tobiwan88/esp32-weatherstation/hardware/gen/README.md

Generators go here (`weatherstation_v1.py` schematic, `layout_v1.py` placement). Not written yet.
Start from `../reference/desk_notifier/gen/` (`schkit.py` works around kicad-sch-api pin rotation and label bugs).
