tobiwan88/esp32-weatherstation/hardware/weatherstation-v1/REQUIREMENTS.md

# esp32-weatherstation v1: PCB requirements (v0.4, schematic v1, pre-layout)

Rewritten 2026-11-01 for the schematic in `hardware/gen/weatherstation_v1.py` (BQ25798, LFP 26700, TPS63802). v0.3 described
the CN3791/TP4056/AP2112K/18650 design, which is gone. Details and part numbers: `BOARD.md`, `bom.csv`, `PARTS-REVIEW.md`.
Status: needs user acceptance (Gate 1, `GATES.md`).

## 1. Scope
Custom 4-layer PCB (In1 and In2 solid GND), at most 50 x 50 mm: ESP32-S3-WROOM-1-N8, one BQ25798 charger for USB-C and a
6 V solar panel, one 1S LiFePO4 cell (CBAK 26700LT) with HY2112-CB protection, TPS63802 3.3 V buck-boost, switched sensor
rail 3V3_SW, switched 5 V rail 5V_SW, a Plantower PMS7003 PM sensor (sensor option A, `sensors.md`), SHT45 on a small
board in a radiation shield, an optional SCD41 CO2 footprint (not fitted), a spare Qwiic
port, and an optional ZE25-O3 ozone module on its own 5 V boost. NO2 is out of scope for v1.

## 2. Functional requirements
- F1 Measure PM1/2.5/10 (PMS7003) and outdoor T/RH (SHT45 in a radiation shield). Optional: CO2 (SCD41, fit U8) and O3
  (ZE25-O3, J8). No VOC/NOx index: Sensirion's index needs about 1 Hz sampling and does not work with deep sleep.
- F2 Wake every 10-15 min (longer in winter if the energy budget needs it), measure, send over WiFi (MQTT / Home Assistant),
  deep sleep.
- F3 Charge the cell from USB-C (VBUS, VAC1) or the solar panel (VAC2) through one charger, U3 BQ25798. Each input has its
  own back-to-back N-FET pair (ACFET/RBFET, AO3400A); the chip selects the input. Solar uses the chip's VOC-based MPPT.
- F4 Fail-safe charge enable: CE is pulled high (R20 to +3V3), so the charger does not charge until firmware has written
  the LFP settings (section 6). A blank or reset MCU means no charging. After that, charging stays enabled at all times,
  including deep sleep (CE held low by GPIO hold; user decision 2026-11-01).
- F5 Temperature: NTC TH1 next to the battery connector on the TS pin. Default state: the chip's JEITA limits apply. During an
  awake charge session firmware may take over (cold charging, `charge-policy.md`).
- F6 Report battery voltage, input voltages and currents, charge state and TS through the charger ADC over I2C
  (charger bus); INT to the MCU.
- F7 Program and debug over native USB-C (USB-JTAG and serial on IO19/IO20); RESET (JP1) and BOOT (JP2, IO0) as tweezer pads (engineer 2026-11-03); two status LEDs on IO41/IO42;
  UART0 header J7 as a fallback.
- F8 Sensor rail 3V3_SW switched by Q40 (P-FET), driven by SENSOR_EN (IO11) through Q41; off by default (R40 pull-up).
- F9 5 V rail 5V_SW (PMS7003 and gas module) from U7 TPS61023 on SYS, EN = BOOST_EN (IO12), R45 pull-down: off by default, output
  disconnected when off.

## 3. Electrical requirements
- Cell: 1S LFP, 3.20 V nominal, 3.65 V charge, 3.75 V limit, 2.0 V cut-off, 3900 mAh minimum (CBAK 26700LT spec A/03).
- Protection: HY2112-CB with M60/M61 (AO3400A) in the cell minus: overcharge 3.75 V, overdischarge 2.10 V, charge and
  discharge overcurrent by the FET drop. F1 PTC 3 A hold between the connector and the battery node. Cell reverse polarity is
  not protected (keyed JST PH).
- Charge current: ICHG at most 1.5 A (HY2112 charge overcurrent margin and L1 rating, `power_budget.py`). Input current clamp
  ILIM_HIZ = 1.59 A (R15/R16); firmware sets IINDPM per source.
- Order of cut-offs: cell 2.0 V <= HY2112 2.10 V < firmware cut-off 2.4 V (sensors off, long sleep).
- 3.3 V: U2 TPS63802 from SYS, 1.3-5.5 V in (1.8 V to start), 2 A, FB 220k/39k = 3.32 V. Covers the whole LFP range.
- PMS7003: 4.5-5.5 V, <= 100 mA active, <= 200 uA standby, stable data 30 s after wake-up (manual V2.5), on 5V_SW; UART2
  IO4 (TX, via R48 1k) / IO5 (RX), SET on IO6 via R49 1k. J2 2x5 1.27 mm, hand-soldered.
- SCD41 (DNP): 2.4-5.5 V, peak 205 mA at 3.3 V, supply ripple <= 30 mV, single shot 0.45 mA average at 1 per 5 min
  (SCD4x datasheet v1.7); on 3V3_SW and the sensor I2C bus; C47 10 uF.
- Gas module: 5V_SW 5.06 V (FB 510k/68k) to ZE25-O3 Vin (3.7-5.5 V). J8 7-pin, numbered 1:1 to the module (Winsen table 2):
  2 DAC (0.4-2.0 V = 0-10 ppm) to IO7, 3 GND, 4 Vin, 5 RXD (0-3.0 V) from IO17 through R46 1k / R47 10k, 6 TXD (0-3.0 V) to
  IO18, 1 and 7 reserved. Supply current and cable pitch open.
- PV input: 6 V class panel, Voc must stay at or below 10 V cold (SMBJ10A standoff). Reference panel Voltaic P110: Vmp 5.71 V,
  Voc 6.94 V, 9.5 W (`board.yaml` panel).
- I2C: charger bus CHG_SDA/CHG_SCL on IO1/IO2 (RTC I2C pins usable by the ULP RISC-V core) with 10k pull-ups to +3V3; sensor bus SEN_SDA/SEN_SCL on IO13/IO14 with 10k
  pull-ups to 3V3_SW (no back-power into unpowered sensors).
- MCU pins: IO1/IO2 charger I2C, IO4/IO5 PM UART, IO6 PM_SET, IO7 GAS_DAC, IO9 CHG_CE, IO10 CHG_INT, IO11 SENSOR_EN, IO12 BOOST_EN, IO17 GAS_TXD, IO18 GAS_RXD, IO19/IO20 USB, IO43/IO44 UART0.
  Strapping pins (IO0, IO3, IO45, IO46) carry no load except BOOT on IO0.
- USB: CC1/CC2 5.1k to GND (sink), D+/D- through 22 ohm to the ESP32 and shared with the BQ25798 D+/D- (BC1.2 detection once,
  then AUTO_INDET_EN = 0).
- Deep-sleep board current target: under 100 uA with 3V3_SW and 5V_SW off (TPS63802 Iq 11 uA, FB divider 13 uA; measure
  the charger and HY2112 share on the first board).
- Energy: average about 10.8 mA at a 600 s cycle, 0.96 Wh/day; 12 days autonomy from 80 % of 3900 mAh; worst-month solar
  4.2 Wh/day with a 10 W panel (`power_budget.py`).

## 4. Environmental / mechanical
- Outdoor station in Germany: -20 to +40 C ambient. Cell: discharge -40 to 60 C, charge -10 to 50 C (spec). PMS7003 working range
  -10 to +60 C, 0-99 %RH (manual V2.5); PM readings above about 80 %RH are flagged (all low-cost PM sensors overread in fog).
- Vented enclosure with rain baffle for the PM inlet; board conformal-coated except connectors. PMS7003 and SCD41 need air exchange with outside air.
- Board at most 50 x 50 mm, M3 mounting holes, ESP32 antenna at the board edge with a keepout on all layers.

## 4a. Thermal
- T1 Heat sources: BQ25798 + L1 (up to 1.5 A charge), TPS63802 + L4, TPS61023 + L5 when on, ESP32 during WiFi TX, PMS7003 (fan) in its own housing.
  Group the converters in one heat corner, away from TH1, the antenna and the sensor connectors.
- T2 TH1 next to J6 and the cell holder, outside the heat corner; sense trace not under a converter. TH1 reads the board next
  to the cell: measure the TH1-to-cell offset on the samples (`charge-policy.md`).
- T3 J2/J3/J8 on the side opposite the heat corner. The SHT45 is off-board in a radiation shield.
- T4 BQ25798 exposed pad, TPS63802 GND bar and ESP32 EP on via arrays into both GND planes.
- T5 Keep the board temperature rise under 25 C at 1.5 A charge in the closed enclosure; verify on the first board.
- T6 Optional milled slots between the heat corner and the sensor side if measurement shows coupling; slots must not cut
  return paths.

## 4b. EMC
- E1 Targets (personal use): EN 55032 Class B emissions, IEC 61000-4-2 +/-4 kV contact / +/-8 kV air on external ports.
  Selling in the EU would need RED testing of the whole product.
- E2 In1 and In2 solid GND, no splits under signals; stitching vias along the edge every 5 mm or closer.
- E3 Switching loops (BQ25798 SW1/SW2 + L1 + PMID/SYS caps, TPS63802, TPS61023) as small as the datasheet layouts; input caps
  next to the pins; no signals under the inductors on the outer layers.
- E4 Antenna keepout on all layers per the WROOM-1 guideline, at least 15 mm from the cell, the PV wiring and metal parts.
- E5 ESD: U4 USBLC6-2SC6 at J1 (D+/D-, VBUS); U5 USBLC6-2SC6 on SEN_SDA/SEN_SCL (outdoor SHT45 cable); D1 SMBJ10A across
  PV+/PV- before the common-mode choke L3 (CMF4532F-900, 90 ohm at 100 MHz, 3 A), C2 after it.
- E6 I2C at 100 kHz, short stubs. Ferrite plus 100 nF at a cable entry only if a scan shows a problem.
- E7 Analog (TS divider, NTC) over solid ground, away from switch nodes.
- E8 Verification: near-field scan, ESD gun on the connectors, scope on the switch nodes and +3V3 ripple, WiFi range with the
  box closed.

## 4c. USB programming and debugging
- U1 Native USB-C J1 on IO19/IO20: flashing, serial console, JTAG. RESET and BOOT buttons.
- U2 USB also powers the board and charges the cell through the BQ25798 (after firmware releases CE).
- U3 UART0 header J7 (3V3, TXD0, RXD0, GND); test points TP1 +3V3 and TP2 SYS.

## 5. Manufacturing (JLCPCB)
- 4 layers, 1.6 mm, ENIG preferred; standard stackup (JLC04161H-7628 or similar), no impedance control needed.
- Stackup: F.Cu parts, signals, power pours / In1 GND / In2 GND / B.Cu signals and power pours. Planes unbroken and stitched.
- SMT top side only (Economic PCBA if JLCPCB accepts the ESP32 module there). Hand-soldered: J5-J8 (JST PH, header).
- Deliverables at layout: Gerbers, drill, BOM, CPL with checked rotations; check exports for metadata before committing.

## 5a. Cost (2026-11-01, `bom.csv` and `hw-check.sh --stock`)
- Parts per board about USD 13.76; Extended fee 15 x USD 3.07 = USD 46.05 per order. 5 boards: about USD 115 in parts plus
  fees, before PCB, setup, stencil, shipping and VAT (Economic PCBA setup about USD 8.18 + stencil USD 1.53).
- Risk: Standard PCBA for the ESP32 module adds about USD 40-50 (check the quote).
- Per station, outside the board (estimates): PMS7003 about EUR 12-18 with cable, SHT45 board a few EUR (own PCB), radiation shield about EUR 8,
  10 W 6 V panel EUR 20-60 (Voltaic P110 USD 65), CBAK 26700LT cell and holder (price open), enclosure about EUR 20, cables EUR 8.

## 6. Firmware requirements
- PMS7003: BOOST_EN (IO12) high -> 30 s warm-up -> read a few frames (passive mode) -> BOOST_EN low (or SET low if the O3
  module keeps 5V_SW on). Drive IO4/IO6 low while 5V_SW is off.
- SHT45 (and SCD41 if fitted): SENSOR_EN (IO11) high -> read (SCD41 single shot, 5 s) -> low. Task watchdog and RTC-timer wake.
- BQ25798 (PARTS-REVIEW B3/B5, 2026-11-01): at every boot write VREG 3.65 V and ICHG before releasing CE (CE is pulled high =
  charge off). Disable the charger I2C watchdog (WATCHDOG = 00), or re-write VREG before each sleep: on watchdog expiry the
  registers return to POR defaults (VREG 4.2 V, ICHG 1 A); the HY2112 3.75 V cut is only the backstop. Keep ICHG at 1.5 A or
  below (L1 Isat 3 A, B4). After the first BC1.2 detection set AUTO_INDET_EN = 0 so D+/D- stay free for the ESP32 USB.
- MPPT: EN_MPPT = 1, VOC_PCT 0.8125 for the reference panel (Vmp/Voc 0.823).
- Charging always on (user, 2026-11-01): CE low and held through deep sleep; TS_IGNORE = 0 in sleep (chip JEITA). Cold
  charging below the chip's limit only in an awake session or by the ULP core (`charge-policy.md`).
- I2C: charger bus IO1/IO2, sensor bus IO13/IO14. Set IO13/IO14 to input or low before switching 3V3_SW off.
- Gas: BOOST_EN (IO12) high = TPS61023 on; drive GAS_TXD (IO17) low or input while the boost is off.
- O3 option (user 2026-11-01): firmware feature to keep 5V_SW on longer for the ZE25-O3 (warm-up <= 3 min, response
  <= 90 s), e.g. one 4 min window per hour (configurable, off by default), with the PMS7003 in sleep (SET low) meanwhile.
  Budget in `board.yaml` cycle.o3_* (current is an assumption until measured).
- Battery: below 2.4 V turn sensors off and sleep long; report the charger ADC values each cycle.

## 7. Open items before ordering
1. ZE25-O3 cable/connector pitch (J8). Supply current: 10 mA at 5 V (user, 2026-11-04).
2. CMF4532F-900 land pattern and pinout from a HongyeX drawing (the footprint uses the EMTEK drawing).
3. JLCPCB Standard vs Economic PCBA for the ESP32 module (quote).
4. SHT45 board: schematic in `hardware/sht45-board/` (layout open).
5. Layout not started; plan one prototype batch and bench-test charging, sleep current and the TH1-to-cell offset.
