tobiwan88/esp32-weatherstation/hardware/weatherstation-v1/weatherstation-v1.kicad_pcb

## KiCad design hardware/weatherstation-v1/weatherstation-v1.kicad_pcb (2026-11-05)

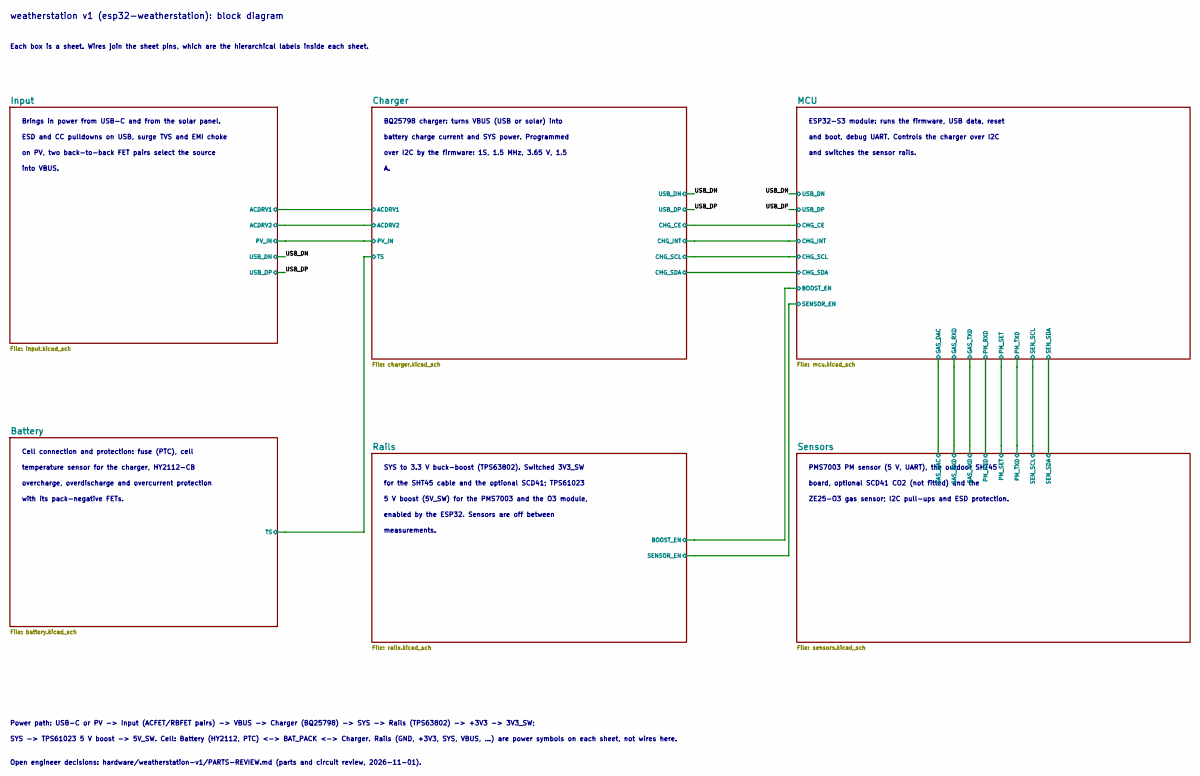
[picture p1: schematic weatherstation-v1.kicad_sch, weatherstation v1]

Notes on the sheet:
weatherstation v1 (esp32-weatherstation): block diagram
Each box is a sheet. Wires join the sheet pins, which are the hierarchical labels inside each sheet.
Power path: USB-C or PV -> Input (ACFET/RBFET pairs) -> VBUS -> Charger (BQ25798) -> SYS -> Rails (TPS63802) -> +3V3 -> 3V3_SW;
SYS -> TPS61023 5 V boost -> 5V_SW. Cell: Battery (HY2112, PTC) <-> BAT_PACK <-> Charger. Rails (GND, +3V3, SYS, VBUS, ...) are power symbols on each sheet, not wires here.
Open engineer decisions: hardware/weatherstation-v1/PARTS-REVIEW.md (parts and circuit review, 2026-11-01).
Brings in power from USB-C and from the solar panel.
ESD and CC pulldowns on USB, surge TVS and EMI choke
on PV, two back-to-back FET pairs select the source
into VBUS.
BQ25798 charger: turns VBUS (USB or solar) into
battery charge current and SYS power. Programmed
over I2C by the firmware: 1S, 1.5 MHz, 3.65 V, 1.5
Cell connection and protection: fuse (PTC), cell
temperature sensor for the charger, HY2112-CB
overcharge, overdischarge and overcurrent protection
with its pack-negative FETs.
ESP32-S3 module: runs the firmware, USB data, reset
and boot, debug UART. Controls the charger over I2C
and switches the sensor rails.
SYS to 3.3 V buck-boost (TPS63802). Switched 3V3_SW
for the SHT45 cable and the optional SCD41; TPS61023
5 V boost (5V_SW) for the PMS7003 and the O3 module,
enabled by the ESP32. Sensors are off between
measurements.
PMS7003 PM sensor (5 V, UART), the outdoor SHT45
board, optional SCD41 CO2 (not fitted) and the
ZE25-O3 gas sensor; I2C pull-ups and ESD protection.

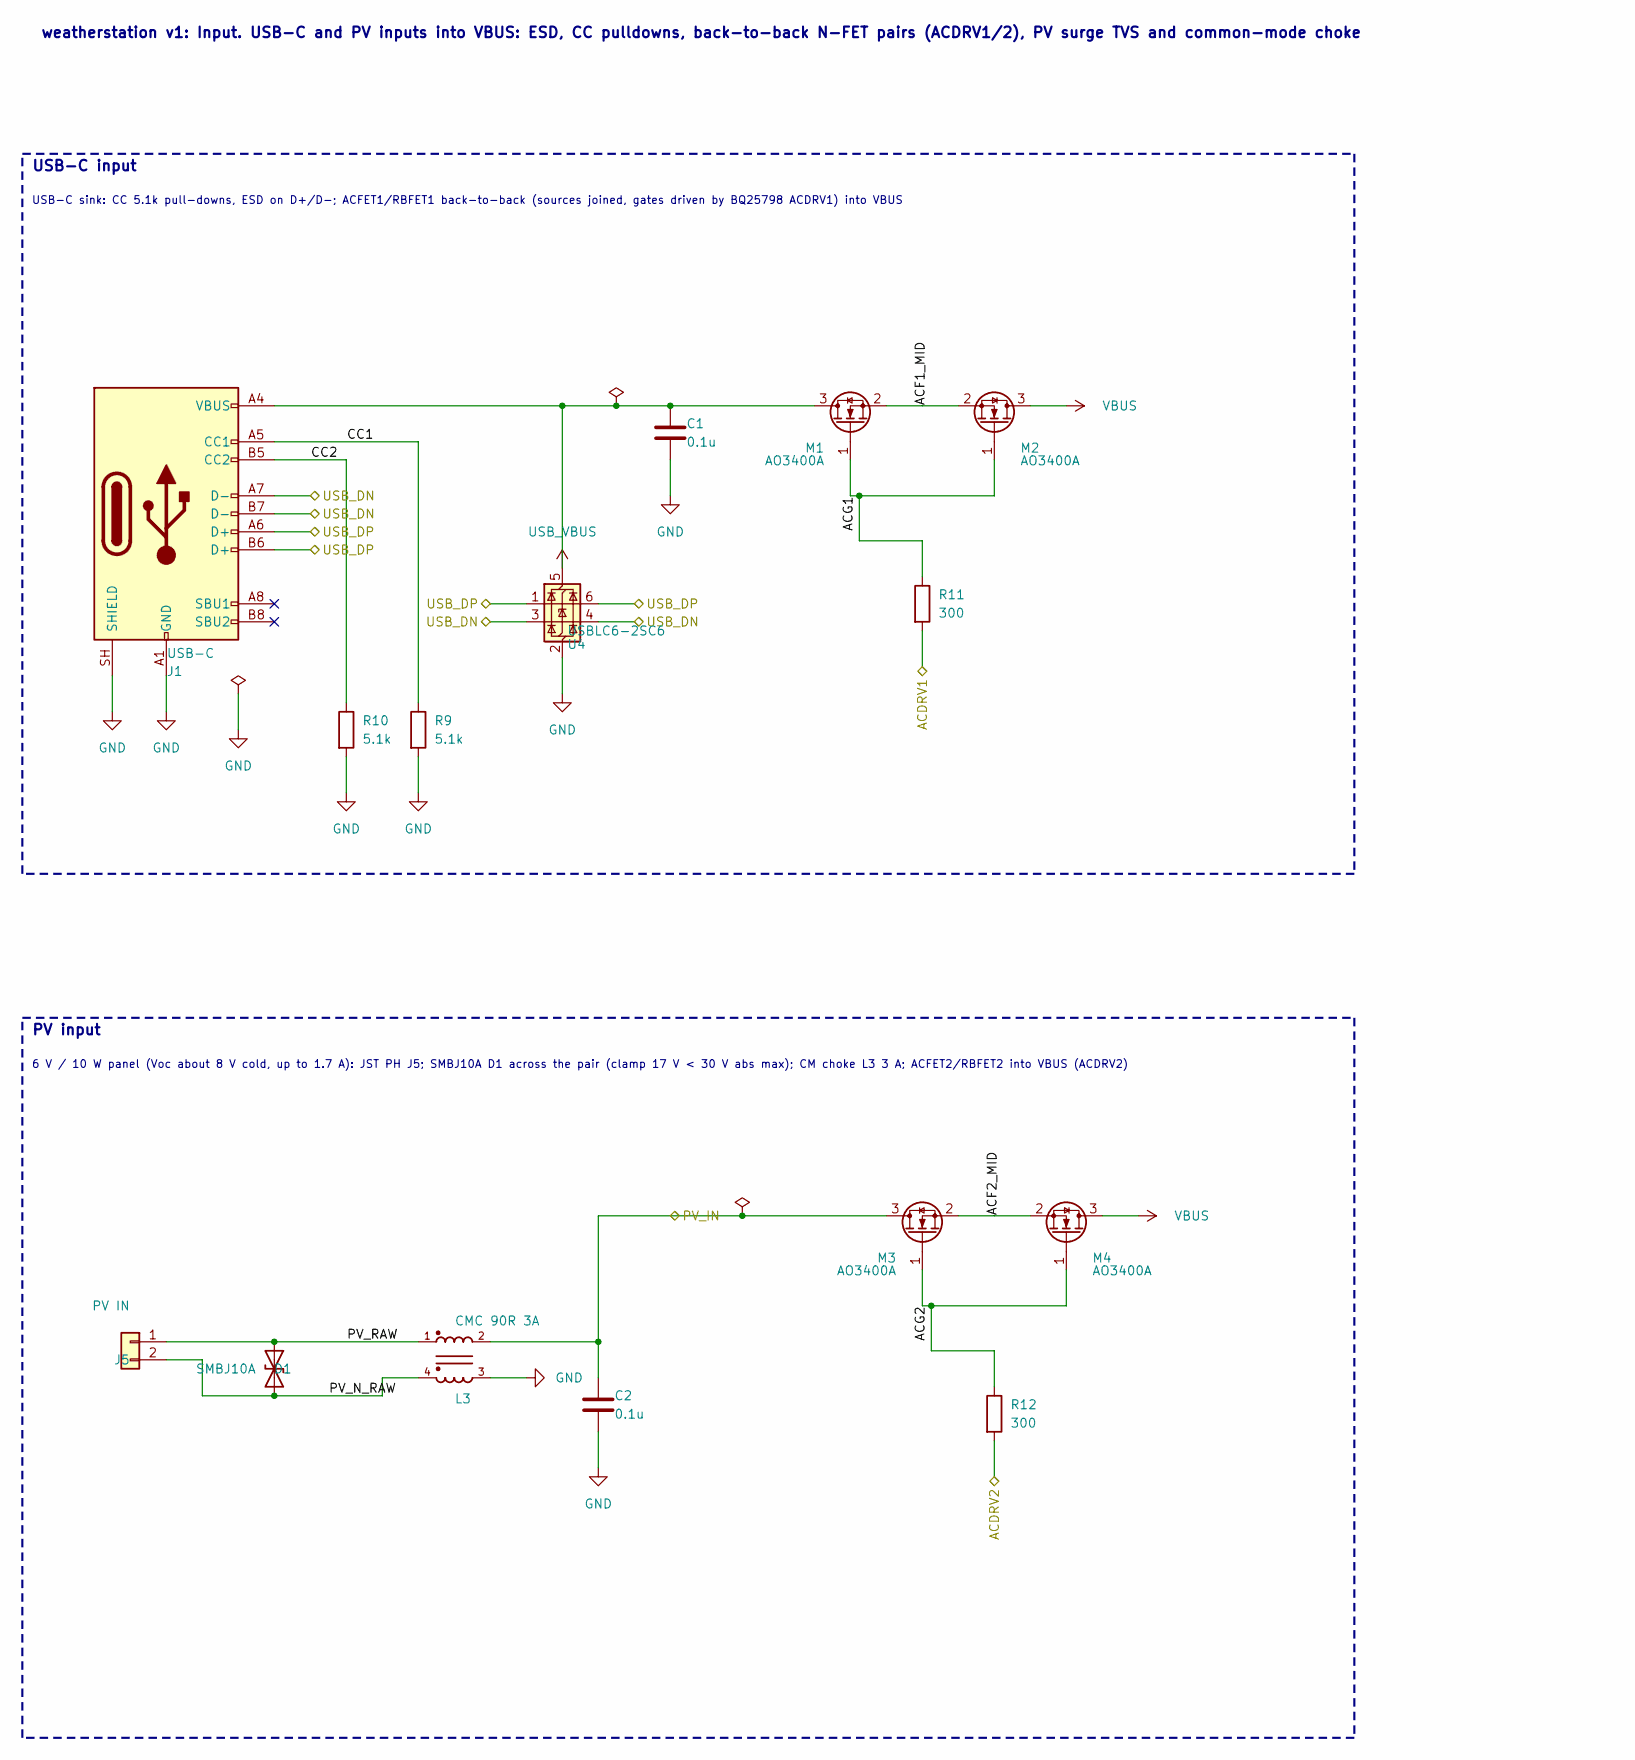
[picture p2: schematic input.kicad_sch, weatherstation v1]

Parts:
C1, C2: 0.1u; C_0402_1005Metric; LCSC C307331
D1: SMBJ10A; D_SMB; LCSC C151250
J1: USB-C; USB_C_Receptacle_HRO_TYPE-C-31-M-12; LCSC C165948
J5: PV IN; JST_PH_B2B-PH-K_1x02_P2.00mm_Vertical
L3: CMC 90R 3A; CMF4532F_4P; LCSC C963746
M1, M2, M3, M4: AO3400A; SOT-23; LCSC C20917
R9, R10: 5.1k; R_0402_1005Metric; LCSC C25905
R11, R12: 300; R_0603_1608Metric; LCSC C23025
U4: USBLC6-2SC6; SOT-23-6; LCSC C7519

Connections:
/Charger/ACDRV1: R11.2; also elsewhere on the board
/Charger/ACDRV2: R12.2; also elsewhere on the board
/Charger/PV_IN: C2.1, L3.2, M3.3 (D); also elsewhere on the board
/Input/ACF1_MID: M1.2 (S), M2.2 (S)
/Input/ACF2_MID: M3.2 (S), M4.2 (S)
/Input/ACG1: M1.1 (G), M2.1 (G), R11.1
/Input/ACG2: M3.1 (G), M4.1 (G), R12.1
/Input/CC1: J1.A5 (CC1), R9.1
/Input/CC2: J1.B5 (CC2), R10.1
/Input/PV_N_RAW: D1.2 (A2), J5.2, L3.4
/Input/PV_RAW: D1.1 (A1), J5.1, L3.1
/USB_DN: J1.A7 (D-), J1.B7 (D-), U4.3 (I/O2), U4.4 (I/O2); also elsewhere on the board
/USB_DP: J1.A6 (D+), J1.B6 (D+), U4.1 (I/O1), U4.6 (I/O1); also elsewhere on the board
GND: C1.2, C2.2, J1.A1 (GND), J1.A12 (GND), J1.B1 (GND), J1.B12 (GND), J1.SH (SHIELD), L3.3, R9.2, R10.2, U4.2 (GND); also elsewhere on the board
USB_VBUS: C1.1, J1.A4 (VBUS), J1.A9 (VBUS), J1.B4 (VBUS), J1.B9 (VBUS), M1.3 (D), U4.5 (VBUS); also elsewhere on the board
VBUS: M2.3 (D), M4.3 (D); also elsewhere on the board

Notes on the sheet:
USB-C input
USB-C sink: CC 5.1k pull-downs, ESD on D+/D-; ACFET1/RBFET1 back-to-back (sources joined, gates driven by BQ25798 ACDRV1) into VBUS
PV input
6 V / 10 W panel (Voc about 8 V cold, up to 1.7 A): JST PH J5; SMBJ10A D1 across the pair (clamp 17 V < 30 V abs max); CM choke L3 3 A; ACFET2/RBFET2 into VBUS (ACDRV2)
weatherstation v1: Input. USB-C and PV inputs into VBUS: ESD, CC pulldowns, back-to-back N-FET pairs (ACDRV1/2), PV surge TVS and common-mode choke

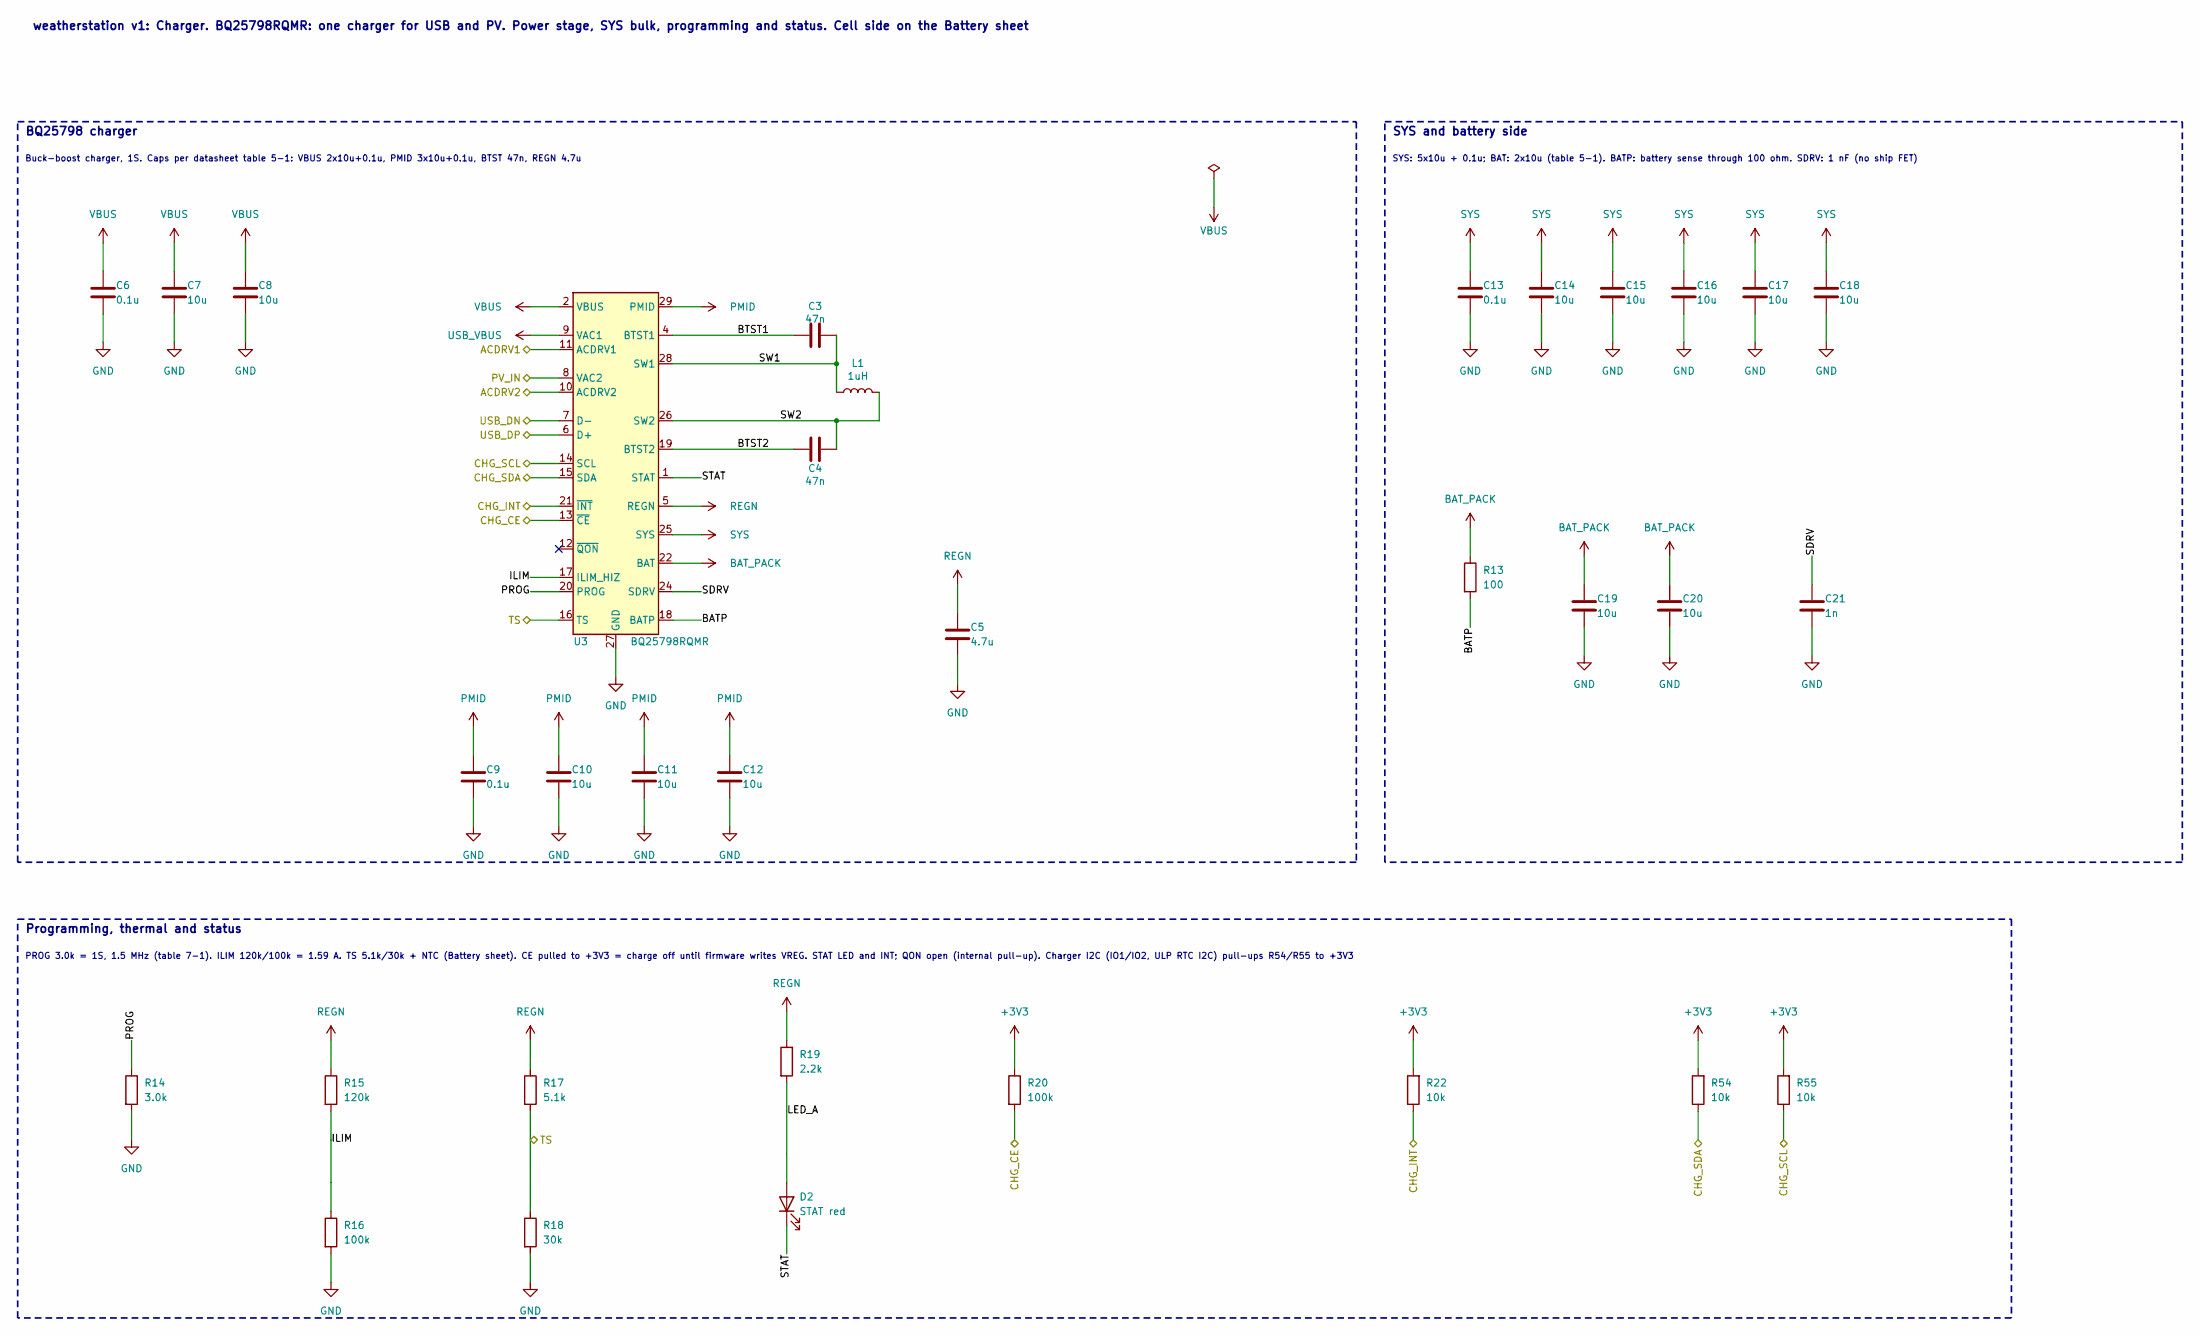
[picture p3: schematic charger.kicad_sch, weatherstation v1]

Parts:
C3, C4: 47n; C_0603_1608Metric; LCSC C1622
C5: 4.7u; C_0603_1608Metric; LCSC C19666
C6, C9, C13: 0.1u; C_0402_1005Metric; LCSC C307331
C7, C8, C10, C11, C12, C14, C15, C16, C17, C18, C19, C20: 10u; C_0805_2012Metric; LCSC C15850
C21: 1n; C_0402_1005Metric; LCSC C1523
D2: STAT red; LED_0603_1608Metric; LCSC C2286
L1: 1uH; L_TDK_VLS252010; LCSC C88211
R13: 100; R_0402_1005Metric; LCSC C25076
R14: 3.0k; R_0603_1608Metric; LCSC C4211
R15: 120k; R_0603_1608Metric; LCSC C25808
R16, R20: 100k; R_0402_1005Metric; LCSC C25741
R17: 5.1k; R_0402_1005Metric; LCSC C25905
R18: 30k; R_0603_1608Metric; LCSC C22984
R19: 2.2k; R_0402_1005Metric; LCSC C25879
R22, R54, R55: 10k; R_0402_1005Metric; LCSC C25744
U3: BQ25798RQMR; Texas_RQM0029A_VQFN-29_4x4mm_P0.4mm; LCSC C2876593

Connections:
+3V3: R20.1, R22.2, R54.2, R55.2; also elsewhere on the board
/Battery/TS: R17.2, R18.1, U3.16 (TS); also elsewhere on the board
/Charger/ACDRV1: U3.11 (ACDRV1); also elsewhere on the board
/Charger/ACDRV2: U3.10 (ACDRV2); also elsewhere on the board
/Charger/BATP: R13.2, U3.18 (BATP)
/Charger/BTST1: C3.1, U3.4 (BTST1)
/Charger/BTST2: C4.1, U3.19 (BTST2)
/Charger/CHG_CE: R20.2, U3.13 (~CE); also elsewhere on the board
/Charger/CHG_INT: R22.1, U3.21 (~INT); also elsewhere on the board
/Charger/CHG_SCL: R55.1, U3.14 (SCL); also elsewhere on the board
/Charger/CHG_SDA: R54.1, U3.15 (SDA); also elsewhere on the board
/Charger/ILIM: R15.2, R16.1, U3.17 (ILIM_HIZ)
/Charger/LED_A: D2.2 (A), R19.2
/Charger/PROG: R14.1, U3.20 (PROG)
/Charger/PV_IN: U3.8 (VAC2); also elsewhere on the board
/Charger/SDRV: C21.1, U3.24 (SDRV)
/Charger/STAT: D2.1 (K), U3.1 (STAT)
/Charger/SW1: C3.2, L1.1, U3.28 (SW1)
/Charger/SW2: C4.2, L1.2, U3.26 (SW2)
/USB_DN: U3.7 (D-); also elsewhere on the board
/USB_DP: U3.6 (D+); also elsewhere on the board
BAT_PACK: C19.1, C20.1, R13.1, U3.22 (BAT), U3.23 (BAT); also elsewhere on the board
GND: C5.2, C6.2, C7.2, C8.2, C9.2, C10.2, C11.2, C12.2, C13.2, C14.2, C15.2, C16.2, C17.2, C18.2, C19.2, C20.2, C21.2, R14.2, R16.2, R18.2, U3.27 (GND); also elsewhere on the board
PMID: C9.1, C10.1, C11.1, C12.1, U3.29 (PMID)
REGN: C5.1, R15.1, R17.1, R19.1, U3.5 (REGN)
SYS: C13.1, C14.1, C15.1, C16.1, C17.1, C18.1, U3.25 (SYS); also elsewhere on the board
USB_VBUS: U3.9 (VAC1); also elsewhere on the board
VBUS: C6.1, C7.1, C8.1, U3.2 (VBUS), U3.3 (VBUS); also elsewhere on the board

Notes on the sheet:
BQ25798 charger
Buck-boost charger, 1S. Caps per datasheet table 5-1: VBUS 2x10u+0.1u, PMID 3x10u+0.1u, BTST 47n, REGN 4.7u
SYS and battery side
SYS: 5x10u + 0.1u; BAT: 2x10u (table 5-1). BATP: battery sense through 100 ohm. SDRV: 1 nF (no ship FET)
Programming, thermal and status
PROG 3.0k = 1S, 1.5 MHz (table 7-1). ILIM 120k/100k = 1.59 A. TS 5.1k/30k + NTC (Battery sheet). CE pulled to +3V3 = charge off until firmware writes VREG. STAT LED and INT; QON open (internal pull-up). Charger I2C (IO1/IO2, ULP RTC I2C) pull-ups R54/R55 to +3V3
weatherstation v1: Charger. BQ25798RQMR: one charger for USB and PV. Power stage, SYS bulk, programming and status. Cell side on the Battery sheet

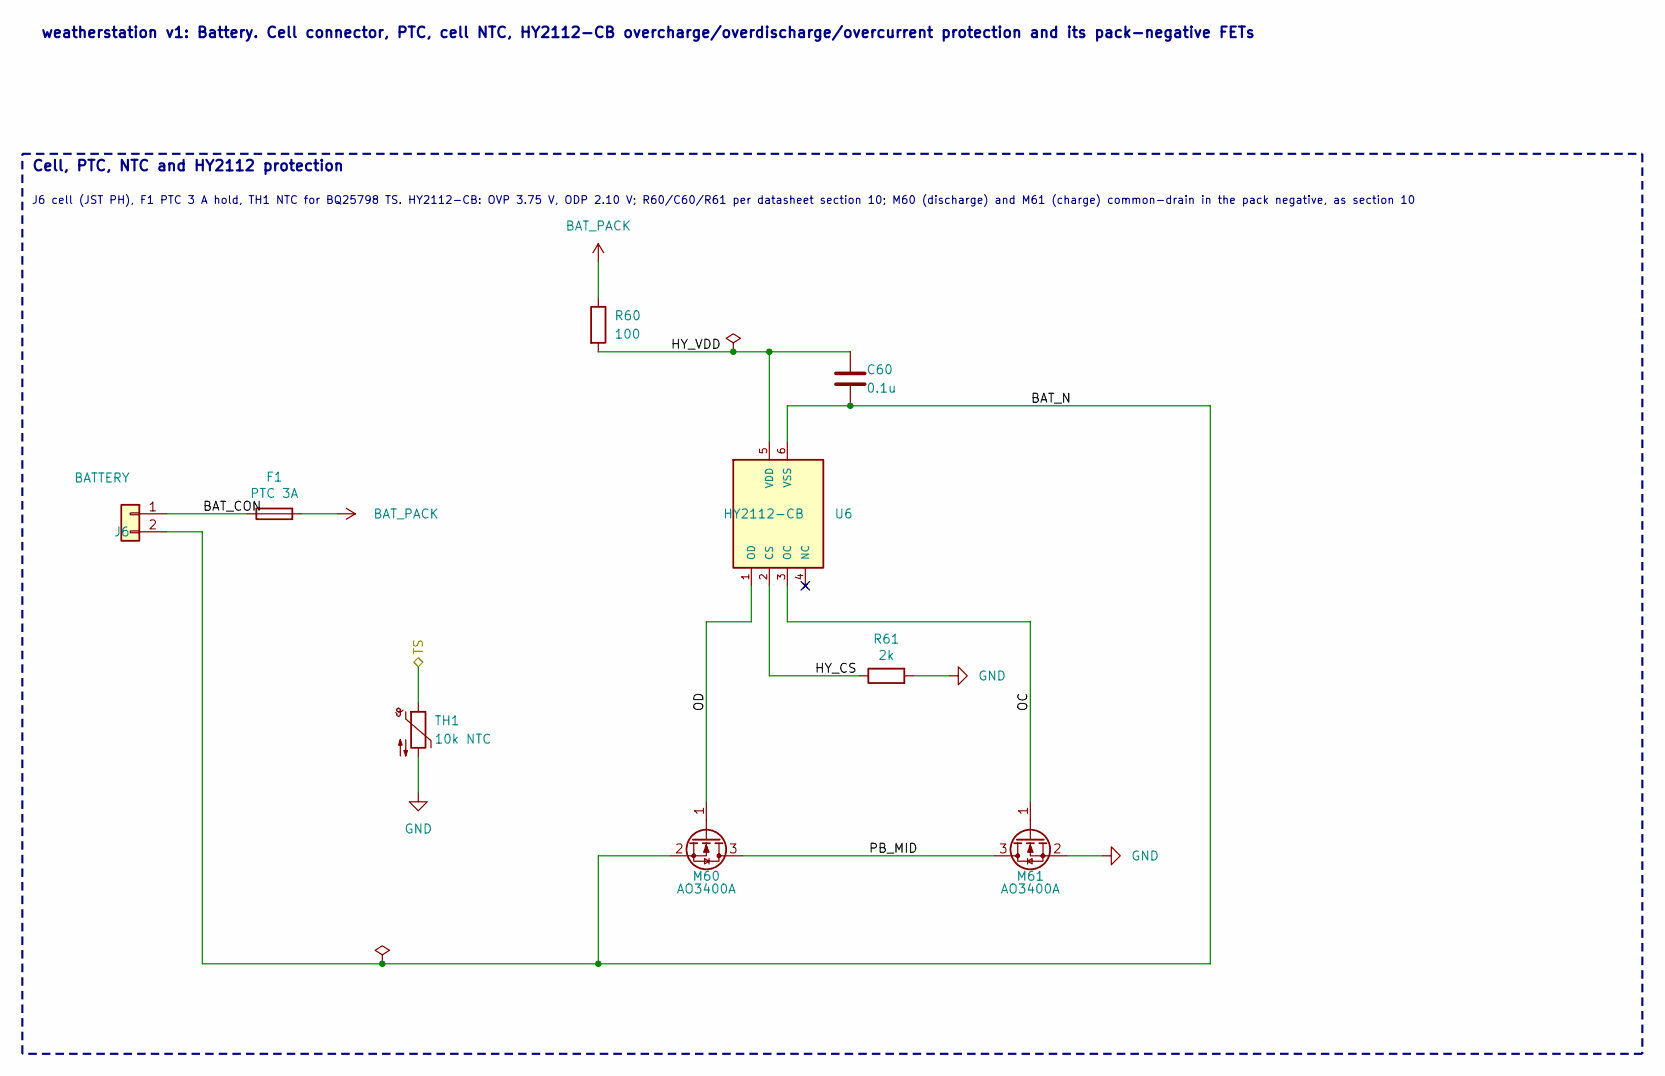
[picture p4: schematic battery.kicad_sch, weatherstation v1]

Parts:
C60: 0.1u; C_0402_1005Metric; LCSC C307331
F1: PTC 3A; Fuse_1812_4532Metric; LCSC C21004
J6: BATTERY; JST_PH_B2B-PH-K_1x02_P2.00mm_Vertical
M60, M61: AO3400A; SOT-23; LCSC C20917
R60: 100; R_0402_1005Metric; LCSC C25076
R61: 2k; R_0402_1005Metric; LCSC C4109
TH1: 10k NTC; R_0603_1608Metric; LCSC C13564
U6: HY2112-CB; SOT-23-6; LCSC C168764

Connections:
/Battery/BAT_CON: F1.1, J6.1
/Battery/BAT_N: C60.2, J6.2, M60.2 (S), U6.6 (VSS)
/Battery/HY_CS: R61.1, U6.2 (CS)
/Battery/HY_VDD: C60.1, R60.2, U6.5 (VDD)
/Battery/OC: M61.1 (G), U6.3 (OC)
/Battery/OD: M60.1 (G), U6.1 (OD)
/Battery/PB_MID: M60.3 (D), M61.3 (D)
/Battery/TS: TH1.1; also elsewhere on the board
BAT_PACK: F1.2, R60.1; also elsewhere on the board
GND: M61.2 (S), R61.2, TH1.2; also elsewhere on the board

Notes on the sheet:
Cell, PTC, NTC and HY2112 protection
J6 cell (JST PH), F1 PTC 3 A hold, TH1 NTC for BQ25798 TS. HY2112-CB: OVP 3.75 V, ODP 2.10 V; R60/C60/R61 per datasheet section 10; M60 (discharge) and M61 (charge) common-drain in the pack negative, as section 10
weatherstation v1: Battery. Cell connector, PTC, cell NTC, HY2112-CB overcharge/overdischarge/overcurrent protection and its pack-negative FETs

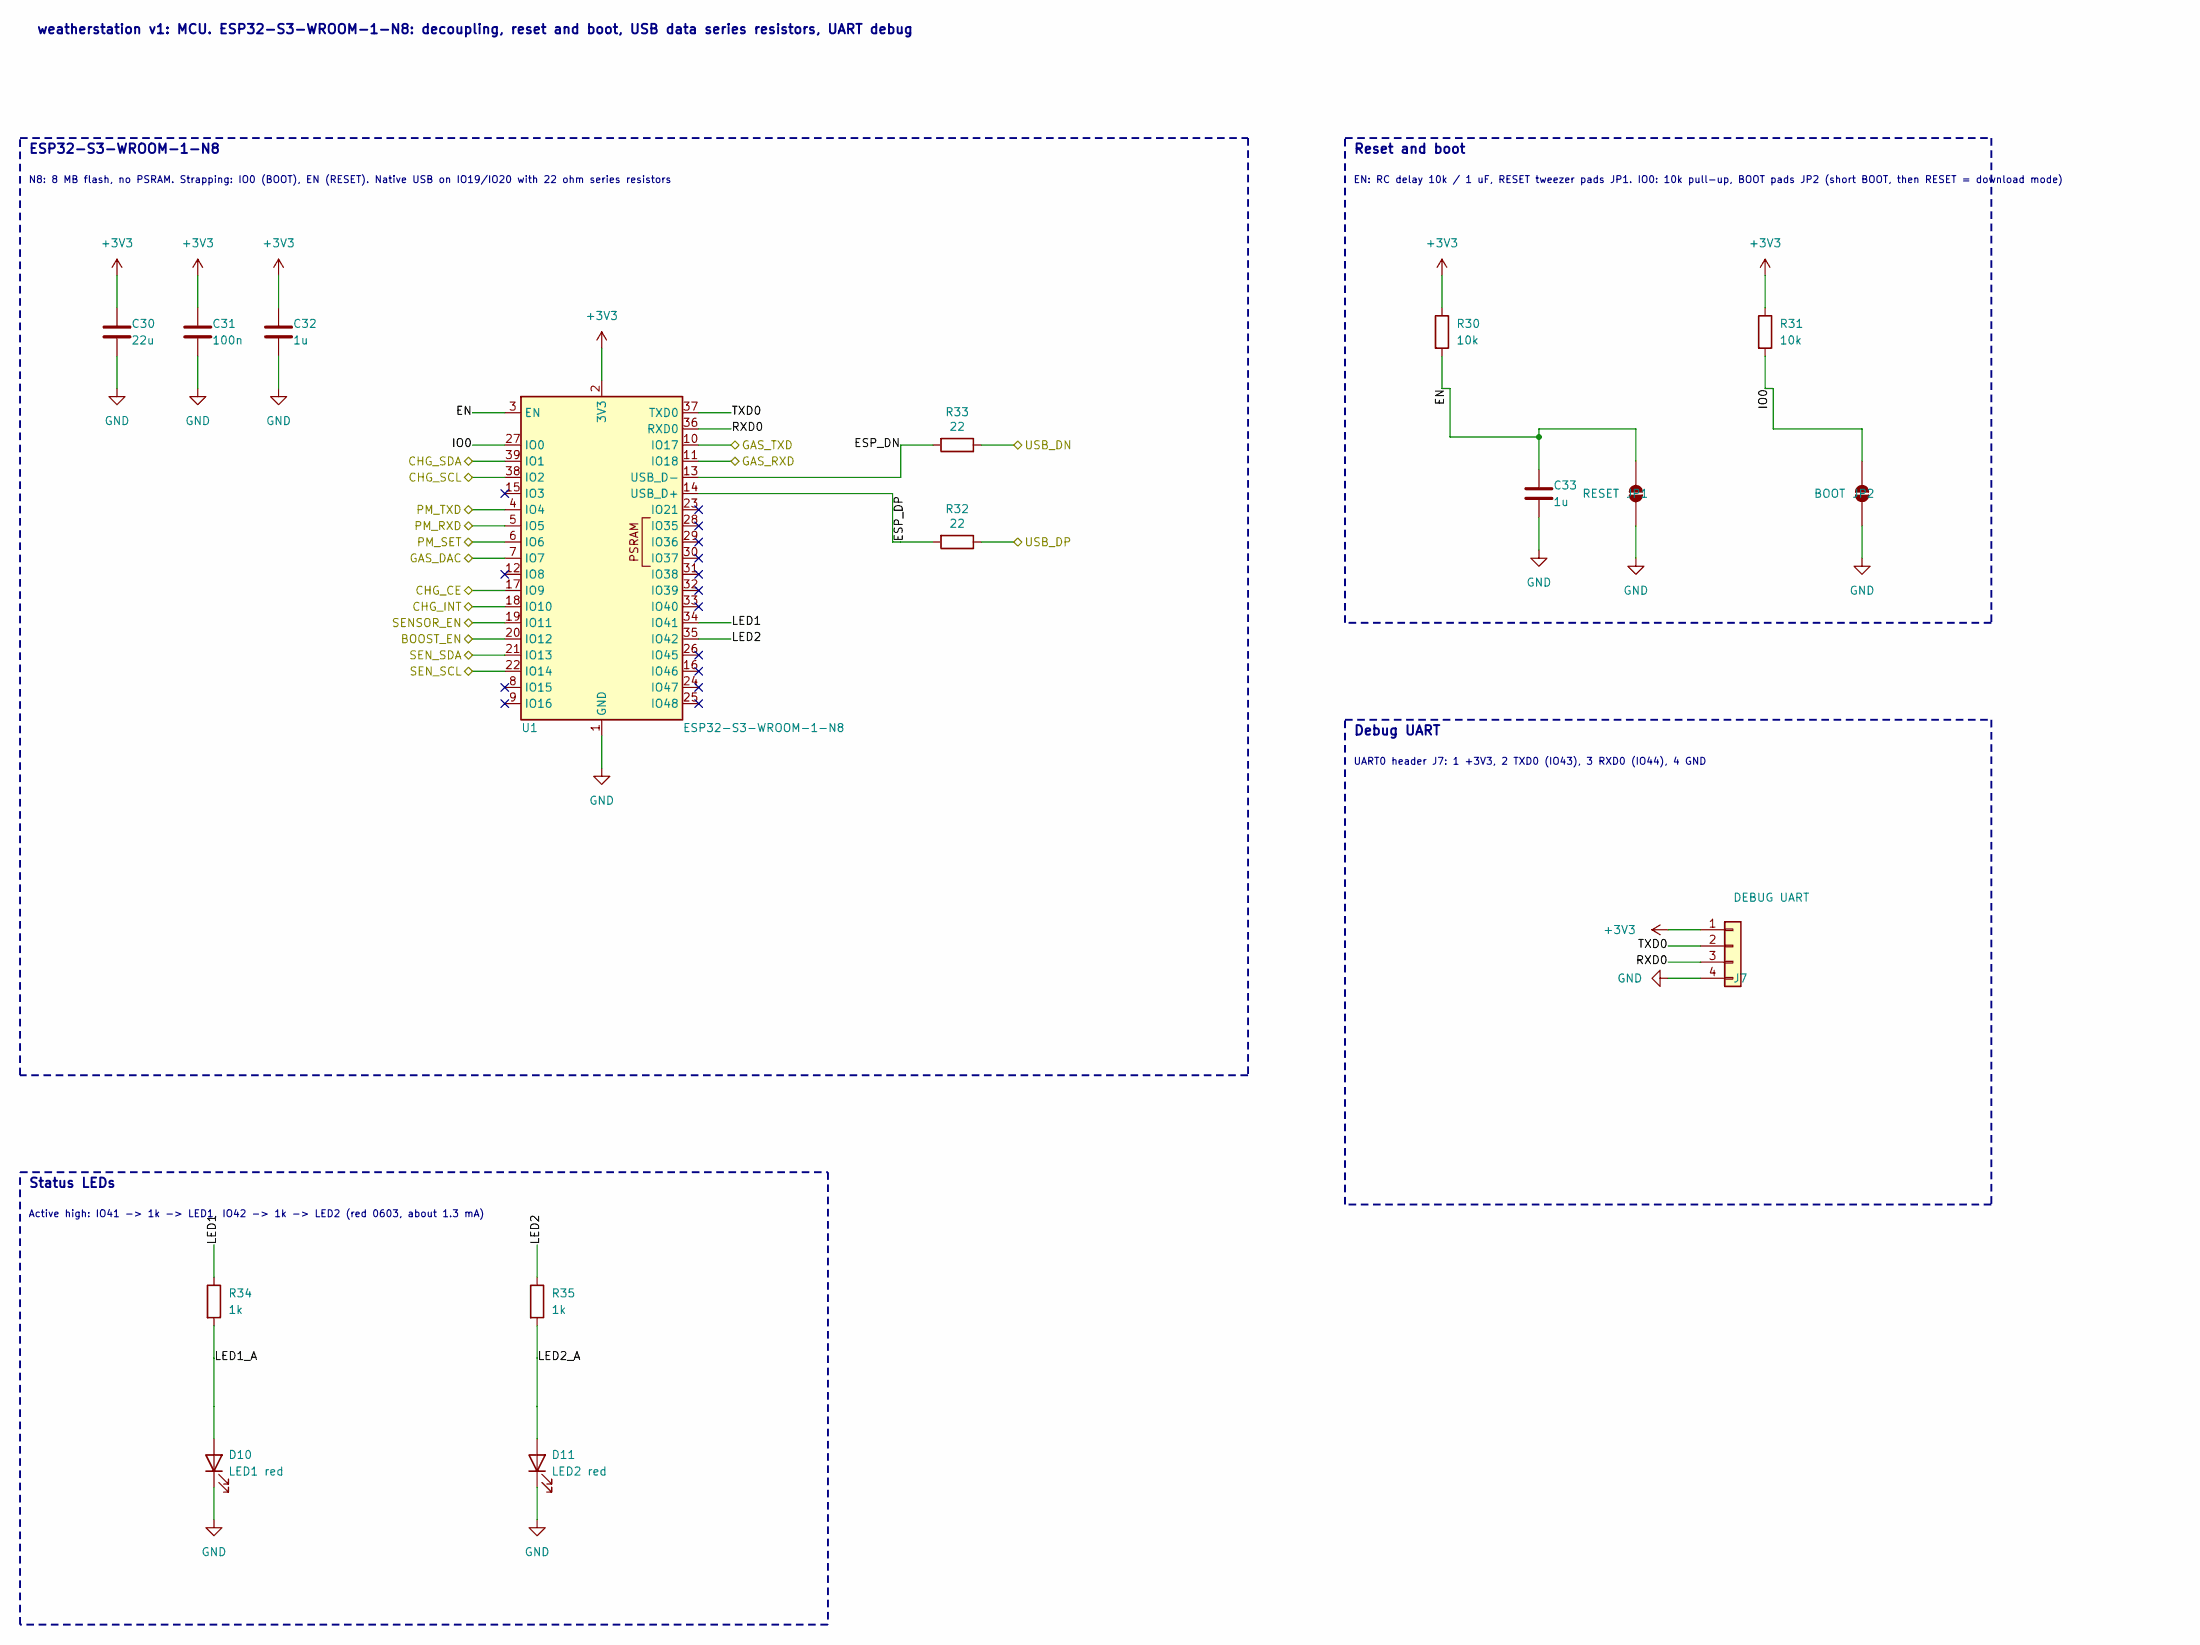
[picture p5: schematic mcu.kicad_sch, weatherstation v1]

Parts:
C30: 22u; C_0805_2012Metric; LCSC C45783
C31: 100n; C_0402_1005Metric; LCSC C307331
C32, C33: 1u; C_0402_1005Metric; LCSC C52923
D10: LED1 red; LED_0603_1608Metric; LCSC C2286
D11: LED2 red; LED_0603_1608Metric; LCSC C2286
J7: DEBUG UART; PinHeader_1x04_P2.54mm_Vertical
JP1: RESET; SolderJumper-2_P1.3mm_Open_RoundedPad1.0x1.5mm
JP2: BOOT; SolderJumper-2_P1.3mm_Open_RoundedPad1.0x1.5mm
R30, R31: 10k; R_0402_1005Metric; LCSC C25744
R32, R33: 22; R_0402_1005Metric; LCSC C25092
R34, R35: 1k; R_0402_1005Metric; LCSC C11702
U1: ESP32-S3-WROOM-1-N8; ESP32-S3-WROOM-1; LCSC C2913198

Connections:
+3V3: C30.1, C31.1, C32.1, J7.1, R30.1, R31.1, U1.2 (3V3); also elsewhere on the board
/Charger/CHG_CE: U1.17 (IO9); also elsewhere on the board
/Charger/CHG_INT: U1.18 (IO10); also elsewhere on the board
/Charger/CHG_SCL: U1.38 (IO2); also elsewhere on the board
/Charger/CHG_SDA: U1.39 (IO1); also elsewhere on the board
/MCU/BOOST_EN: U1.20 (IO12); also elsewhere on the board
/MCU/EN: C33.1, JP1.1 (A), R30.2, U1.3 (EN)
/MCU/ESP_DN: R33.2, U1.13 (USB_D-)
/MCU/ESP_DP: R32.2, U1.14 (USB_D+)
/MCU/GAS_DAC: U1.7 (IO7); also elsewhere on the board
/MCU/GAS_RXD: U1.11 (IO18); also elsewhere on the board
/MCU/GAS_TXD: U1.10 (IO17); also elsewhere on the board
/MCU/IO0: JP2.1 (A), R31.2, U1.27 (IO0)
/MCU/LED1: R34.1, U1.34 (IO41)
/MCU/LED1_A: D10.2 (A), R34.2
/MCU/LED2: R35.1, U1.35 (IO42)
/MCU/LED2_A: D11.2 (A), R35.2
/MCU/PM_RXD: U1.5 (IO5); also elsewhere on the board
/MCU/PM_SET: U1.6 (IO6); also elsewhere on the board
/MCU/PM_TXD: U1.4 (IO4); also elsewhere on the board
/MCU/RXD0: J7.3, U1.36 (RXD0)
/MCU/SENSOR_EN: U1.19 (IO11); also elsewhere on the board
/MCU/SEN_SCL: U1.22 (IO14); also elsewhere on the board
/MCU/SEN_SDA: U1.21 (IO13); also elsewhere on the board
/MCU/TXD0: J7.2, U1.37 (TXD0)
/USB_DN: R33.1; also elsewhere on the board
/USB_DP: R32.1; also elsewhere on the board
GND: C30.2, C31.2, C32.2, C33.2, D10.1 (K), D11.1 (K), J7.4, JP1.2 (B), JP2.2 (B), U1.1 (GND), U1.40 (GND), U1.41 (GND); also elsewhere on the board

Notes on the sheet:
ESP32-S3-WROOM-1-N8
N8: 8 MB flash, no PSRAM. Strapping: IO0 (BOOT), EN (RESET). Native USB on IO19/IO20 with 22 ohm series resistors
Reset and boot
EN: RC delay 10k / 1 uF, RESET tweezer pads JP1. IO0: 10k pull-up, BOOT pads JP2 (short BOOT, then RESET = download mode)
Debug UART
UART0 header J7: 1 +3V3, 2 TXD0 (IO43), 3 RXD0 (IO44), 4 GND
Status LEDs
Active high: IO41 -> 1k -> LED1, IO42 -> 1k -> LED2 (red 0603, about 1.3 mA)
weatherstation v1: MCU. ESP32-S3-WROOM-1-N8: decoupling, reset and boot, USB data series resistors, UART debug

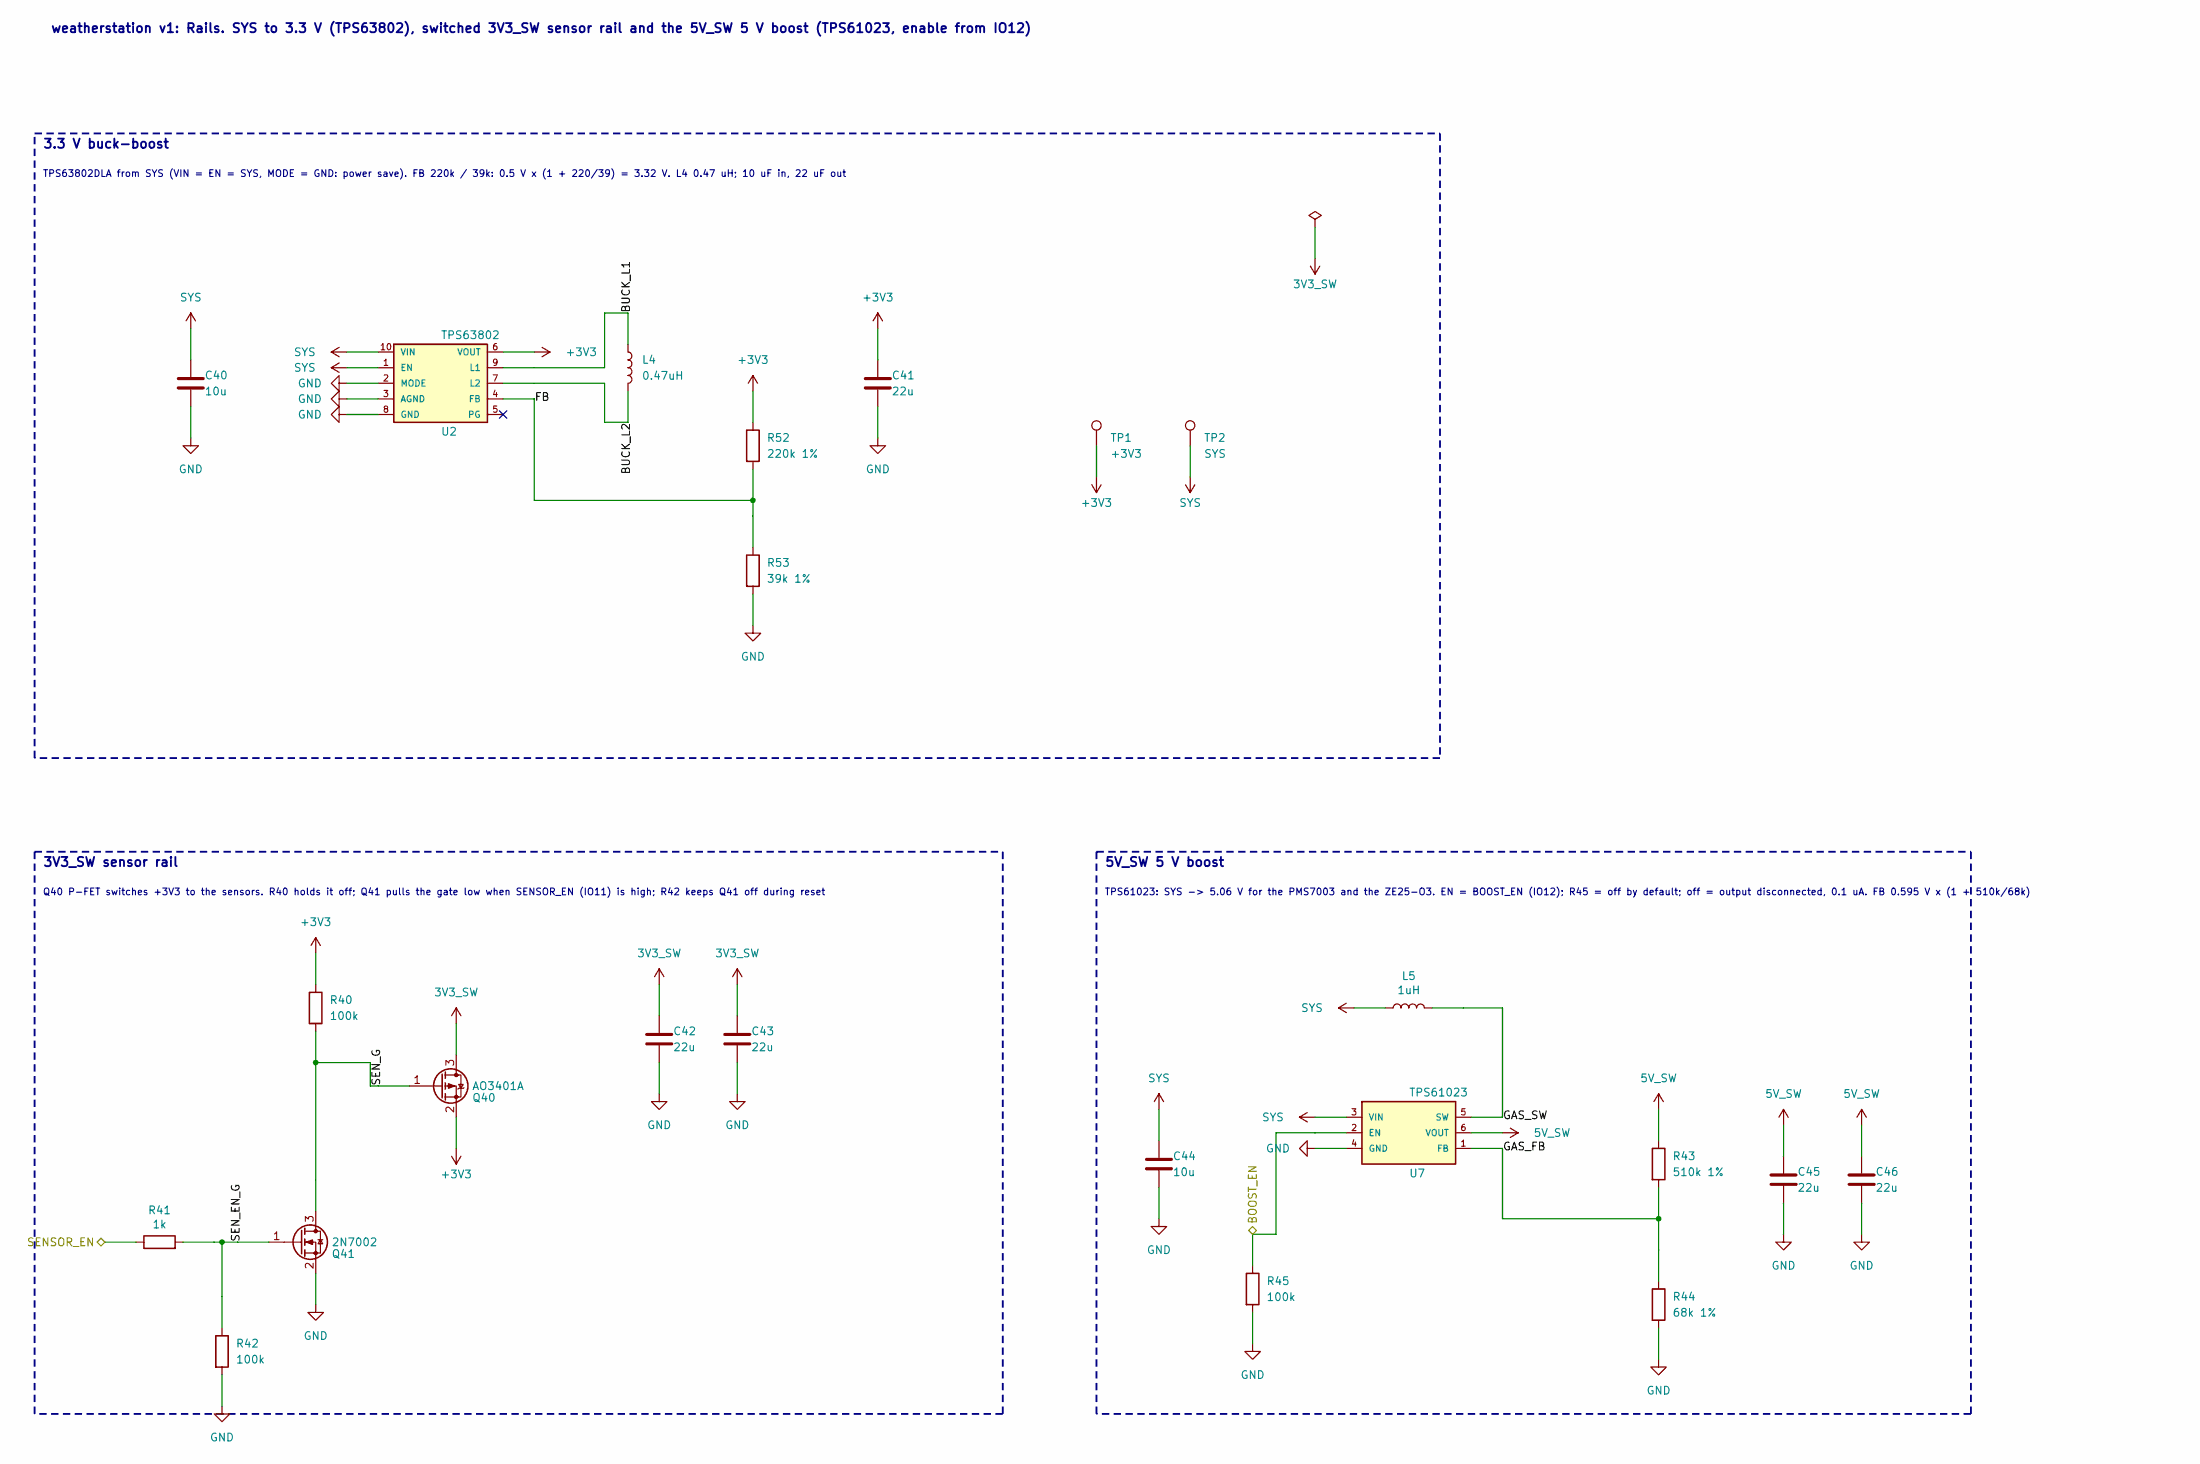
[picture p6: schematic rails.kicad_sch, weatherstation v1]

Parts:
C40, C44: 10u; C_0603_1608Metric; LCSC C19702
C41, C42, C43, C45, C46: 22u; C_0805_2012Metric; LCSC C45783
L4: 0.47uH; L_Sunlord_WPN201610H; LCSC C97009
L5: 1uH; L_TDK_VLS252010; LCSC C88211
Q40: AO3401A; SOT-23; LCSC C15127
Q41: 2N7002; SOT-23; LCSC C8545
R40, R42, R45: 100k; R_0402_1005Metric; LCSC C25741
R41: 1k; R_0402_1005Metric; LCSC C11702
R43: 510k 1%; R_0603_1608Metric; LCSC C23192
R44: 68k 1%; R_0603_1608Metric; LCSC C23231
R52: 220k 1%; R_0603_1608Metric; LCSC C22961
R53: 39k 1%; R_0603_1608Metric; LCSC C23153
TP1: +3V3; TestPoint_Pad_D1.5mm
TP2: SYS; TestPoint_Pad_D1.5mm
U2: TPS63802; TPS63802_DLA_VSON-HR-10_2x3mm; LCSC C2845237
U7: TPS61023; SOT-563; LCSC C919459

Connections:
3V3_SW: C42.1, C43.1, Q40.3 (D); also elsewhere on the board
5V_SW: C45.1, C46.1, R43.1, U7.6 (VOUT); also elsewhere on the board
+3V3: C41.1, Q40.2 (S), R40.1, R52.1, TP1.1, U2.6 (VOUT); also elsewhere on the board
/MCU/BOOST_EN: R45.1, U7.2 (EN); also elsewhere on the board
/MCU/SENSOR_EN: R41.1; also elsewhere on the board
/Rails/BUCK_L1: L4.1, U2.9 (L1)
/Rails/BUCK_L2: L4.2, U2.7 (L2)
/Rails/FB: R52.2, R53.1, U2.4 (FB)
/Rails/GAS_FB: R43.2, R44.1, U7.1 (FB)
/Rails/GAS_SW: L5.2, U7.5 (SW)
/Rails/SEN_EN_G: Q41.1 (G), R41.2, R42.1
/Rails/SEN_G: Q40.1 (G), Q41.3 (D), R40.2
GND: C40.2, C41.2, C42.2, C43.2, C44.2, C45.2, C46.2, Q41.2 (S), R42.2, R44.2, R45.2, R53.2, U2.2 (MODE), U2.3 (AGND), U2.8 (GND), U7.4 (GND); also elsewhere on the board
SYS: C40.1, C44.1, L5.1, TP2.1, U2.1 (EN), U2.10 (VIN), U7.3 (VIN); also elsewhere on the board

Notes on the sheet:
3.3 V buck-boost
TPS63802DLA from SYS (VIN = EN = SYS, MODE = GND: power save). FB 220k / 39k: 0.5 V x (1 + 220/39) = 3.32 V. L4 0.47 uH; 10 uF in, 22 uF out
3V3_SW sensor rail
Q40 P-FET switches +3V3 to the sensors. R40 holds it off; Q41 pulls the gate low when SENSOR_EN (IO11) is high; R42 keeps Q41 off during reset
5V_SW 5 V boost
TPS61023: SYS -> 5.06 V for the PMS7003 and the ZE25-O3. EN = BOOST_EN (IO12); R45 = off by default; off = output disconnected, 0.1 uA. FB 0.595 V x (1 + 510k/68k)
weatherstation v1: Rails. SYS to 3.3 V (TPS63802), switched 3V3_SW sensor rail and the 5V_SW 5 V boost (TPS61023, enable from IO12)
