tobiwan88/esp32-weatherstation/hardware/weatherstation-v1/weatherstation-v1.kicad_pcb

## KiCad design hardware/weatherstation-v1/weatherstation-v1.kicad_pcb (continued)

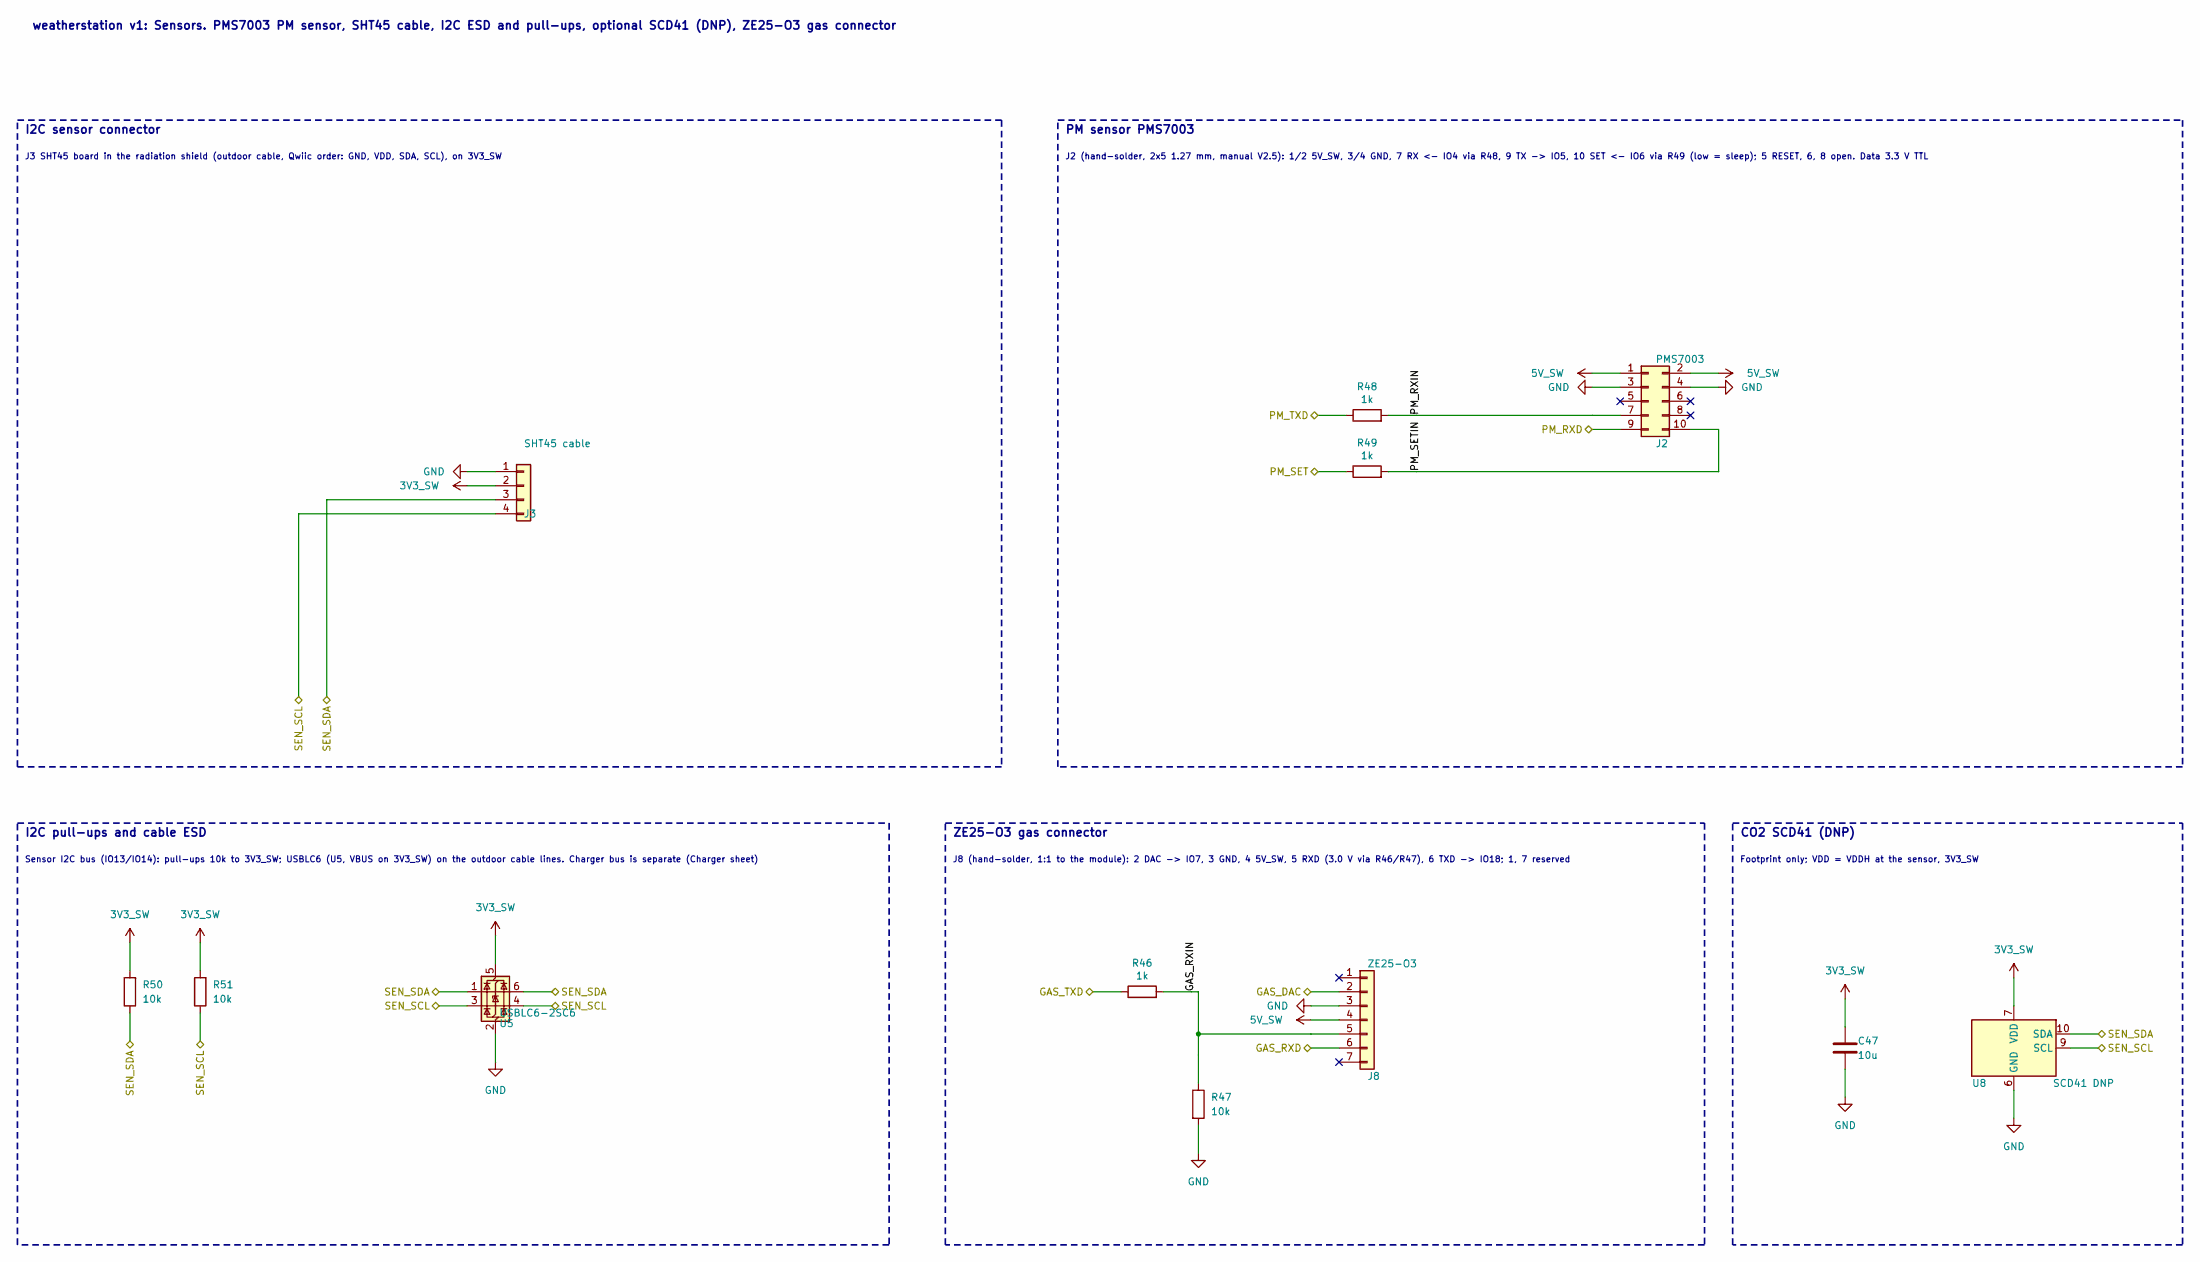
[picture p7: schematic sensors.kicad_sch, weatherstation v1]

Parts:
C47: 10u; C_0603_1608Metric; LCSC C19702
J2: PMS7003; PinHeader_2x05_P1.27mm_Vertical
J3: SHT45 cable; JST_SH_SM04B-SRSS-TB_1x04-1MP_P1.00mm_Horizontal; LCSC C160404
J8: ZE25-O3; JST_PH_B7B-PH-K_1x07_P2.00mm_Vertical
R46, R48, R49: 1k; R_0402_1005Metric; LCSC C11702
R47, R50, R51: 10k; R_0402_1005Metric; LCSC C25744
U5: USBLC6-2SC6; SOT-23-6; LCSC C7519
U8: SCD41 DNP; Sensirion_SCD4x-1EP_10.1x10.1mm_P1.25mm_EP4.8x4.8mm

Connections:
3V3_SW: C47.1, J3.2, R50.2, R51.2, U5.5 (VBUS), U8.7 (VDD), U8.19 (VDD); also elsewhere on the board
5V_SW: J2.1, J2.2, J8.4; also elsewhere on the board
/MCU/GAS_DAC: J8.2; also elsewhere on the board
/MCU/GAS_RXD: J8.6; also elsewhere on the board
/MCU/GAS_TXD: R46.1; also elsewhere on the board
/MCU/PM_RXD: J2.9; also elsewhere on the board
/MCU/PM_SET: R49.1; also elsewhere on the board
/MCU/PM_TXD: R48.1; also elsewhere on the board
/MCU/SEN_SCL: J3.4, R51.1, U5.3 (I/O2), U5.4 (I/O2), U8.9 (SCL); also elsewhere on the board
/MCU/SEN_SDA: J3.3, R50.1, U5.1 (I/O1), U5.6 (I/O1), U8.10 (SDA); also elsewhere on the board
/Sensors/GAS_RXIN: J8.5, R46.2, R47.1
/Sensors/PM_RXIN: J2.7, R48.2
/Sensors/PM_SETIN: J2.10, R49.2
GND: C47.2, J2.3, J2.4, J3.1, J8.3, R47.2, U5.2 (GND), U8.6 (GND), U8.20 (GND), U8.21 (GND); also elsewhere on the board

Notes on the sheet:
I2C sensor connector
J3 SHT45 board in the radiation shield (outdoor cable, Qwiic order: GND, VDD, SDA, SCL), on 3V3_SW
PM sensor PMS7003
J2 (hand-solder, 2x5 1.27 mm, manual V2.5): 1/2 5V_SW, 3/4 GND, 7 RX <- IO4 via R48, 9 TX -> IO5, 10 SET <- IO6 via R49 (low = sleep); 5 RESET, 6, 8 open. Data 3.3 V TTL
CO2 SCD41 (DNP)
Footprint only; VDD = VDDH at the sensor, 3V3_SW
I2C pull-ups and cable ESD
Sensor I2C bus (IO13/IO14): pull-ups 10k to 3V3_SW; USBLC6 (U5, VBUS on 3V3_SW) on the outdoor cable lines. Charger bus is separate (Charger sheet)
ZE25-O3 gas connector
J8 (hand-solder, 1:1 to the module): 2 DAC -> IO7, 3 GND, 4 5V_SW, 5 RXD (3.0 V via R46/R47), 6 TXD -> IO18; 1, 7 reserved
weatherstation v1: Sensors. PMS7003 PM sensor, SHT45 cable, I2C ESD and pull-ups, optional SCD41 (DNP), ZE25-O3 gas connector

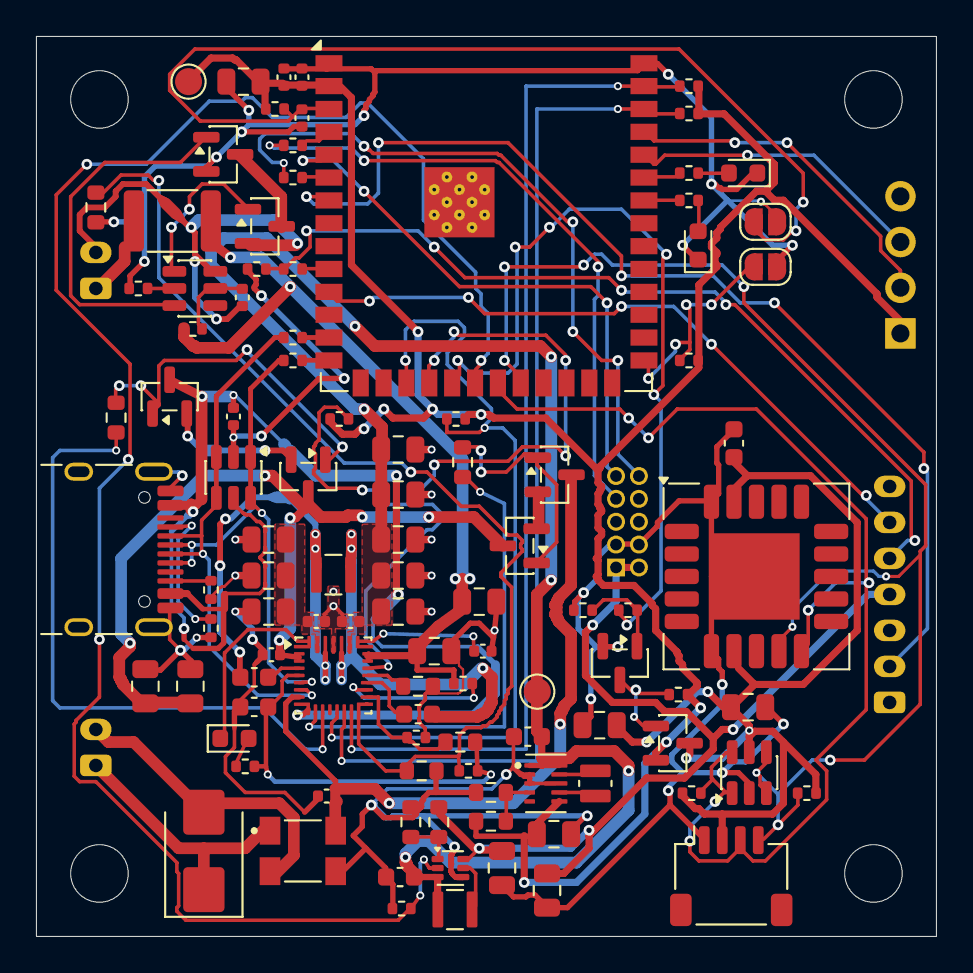
[picture p8: board weatherstation-v1.kicad_pcb from above]

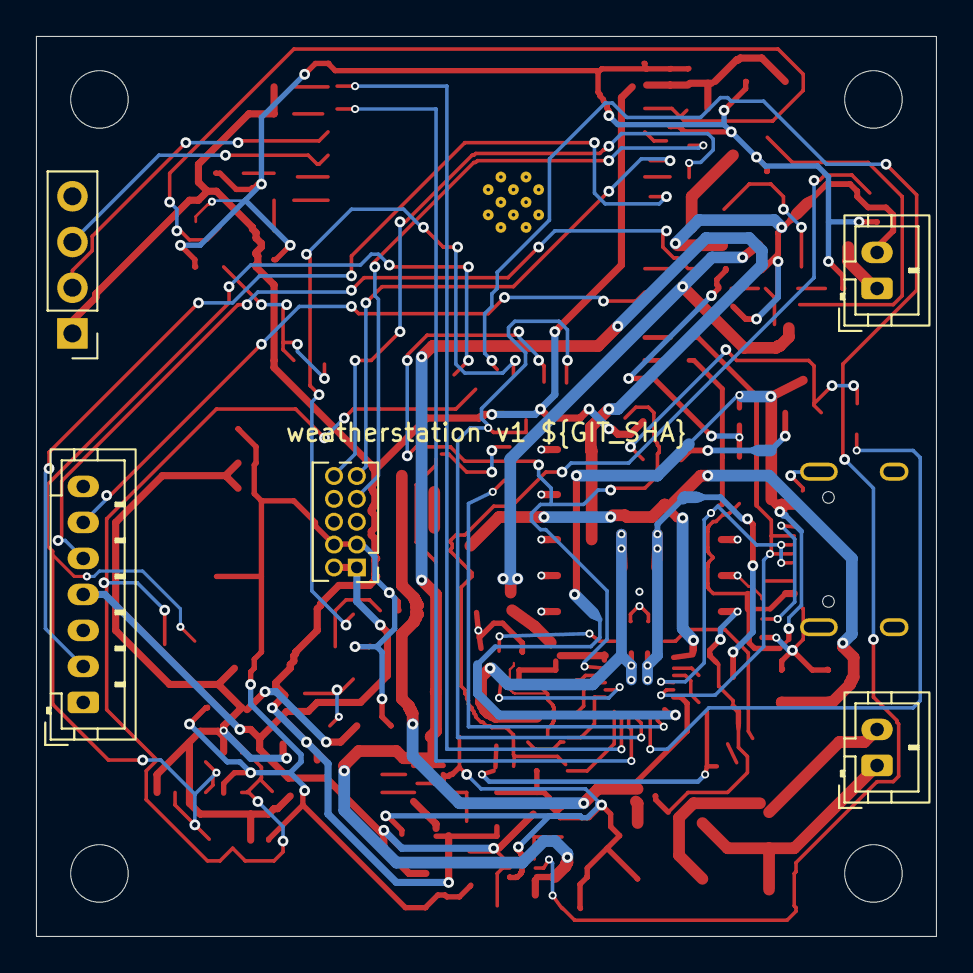
[picture p9: board weatherstation-v1.kicad_pcb from below]

Board: 4 copper layers, 50.0 x 50.0 mm, 112 parts (5 on the bottom side), 75 nets.

Other parts of the board:
H1, H2, H3, H4: MountingHole_3.2mm_M3_ISO7380
