tobiwan88/esp32-weatherstation/hardware/bmp585-board/bmp585-board.kicad_pcb

## KiCad design hardware/bmp585-board/bmp585-board.kicad_pcb (2026-11-04)

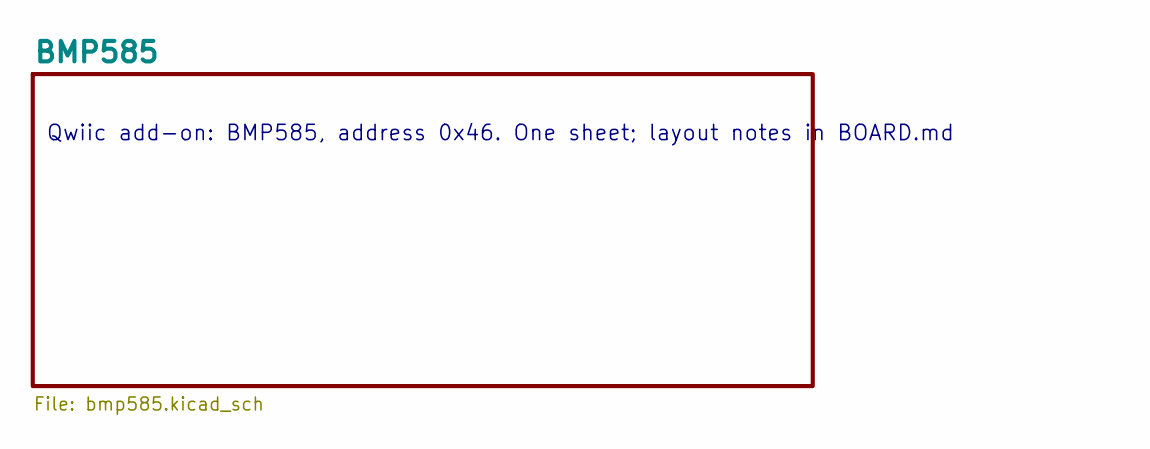
[picture p10: schematic bmp585-board.kicad_sch, BMP585 pressure add-on (Qwiic)]

Notes on the sheet:
Qwiic add-on: BMP585, address 0x46. One sheet; layout notes in BOARD.md

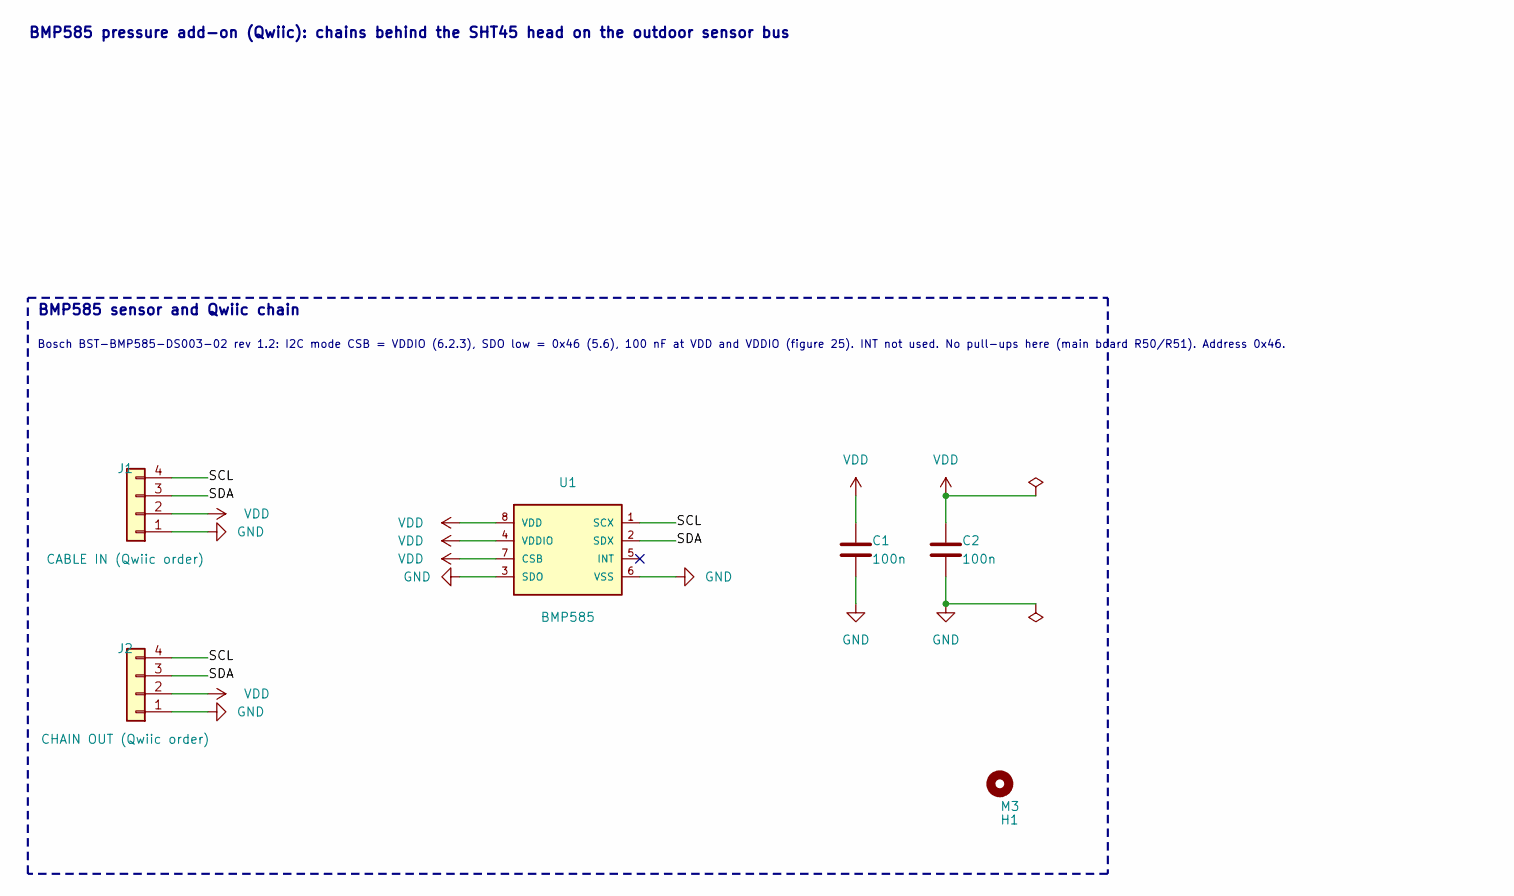
[picture p11: schematic bmp585.kicad_sch, BMP585 pressure add-on (Qwiic)]

Parts:
C1, C2: 100n; C_0603_1608Metric; LCSC C14663
H1: M3; MountingHole_3.2mm_M3
J1: CABLE IN (Qwiic order); JST_SH_SM04B-SRSS-TB_1x04-1MP_P1.00mm_Horizontal; LCSC C160404
J2: CHAIN OUT (Qwiic order); JST_SH_SM04B-SRSS-TB_1x04-1MP_P1.00mm_Horizontal; LCSC C160404
U1: BMP585; BMP585_LGA-8_3.25x3.25mm; LCSC C18184976

Connections:
/BMP585/SCL: J1.4, J2.4, U1.1 (SCX)
/BMP585/SDA: J1.3, J2.3, U1.2 (SDX)
GND: C1.2, C2.2, J1.1, J2.1, U1.3 (SDO), U1.6 (VSS)
VDD: C1.1, C2.1, J1.2, J2.2, U1.4 (VDDIO), U1.7 (CSB), U1.8 (VDD)

Notes on the sheet:
BMP585 sensor and Qwiic chain
Bosch BST-BMP585-DS003-02 rev 1.2: I2C mode CSB = VDDIO (6.2.3), SDO low = 0x46 (5.6), 100 nF at VDD and VDDIO (figure 25). INT not used. No pull-ups here (main board R50/R51). Address 0x46.
BMP585 pressure add-on (Qwiic): chains behind the SHT45 head on the outdoor sensor bus

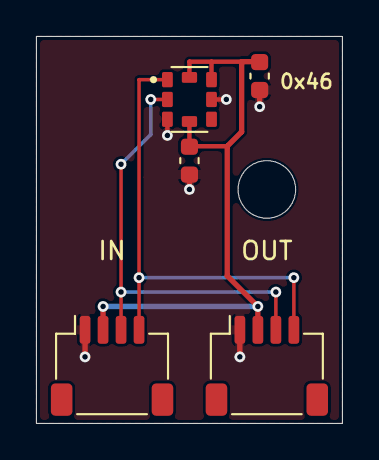
[picture p12: board bmp585-board.kicad_pcb from above]

Board: 2 copper layers, 17.0 x 21.5 mm, 6 parts (0 on the bottom side), 4 nets.
