tobiwan88/esp32-weatherstation/hardware/sht45-board/sht45-board.kicad_pcb

## KiCad design hardware/sht45-board/sht45-board.kicad_pcb (2026-11-04)

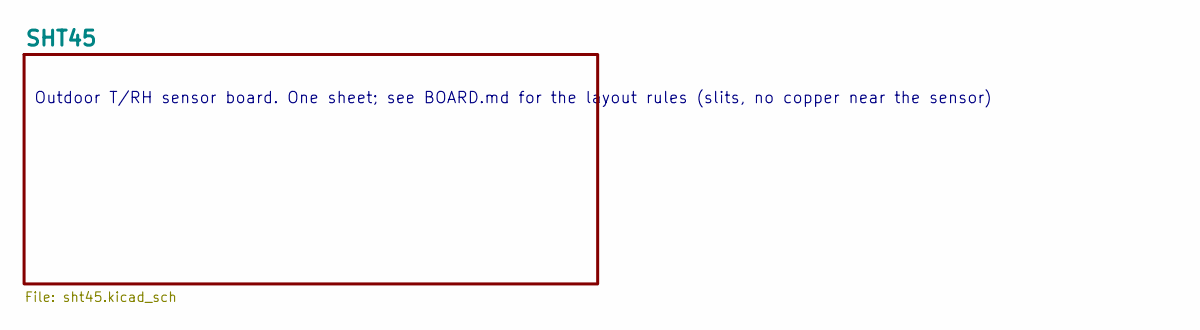
[picture p13: schematic sht45-board.kicad_sch, SHT45 outdoor T/RH board]

Notes on the sheet:
Outdoor T/RH sensor board. One sheet; see BOARD.md for the layout rules (slits, no copper near the sensor)

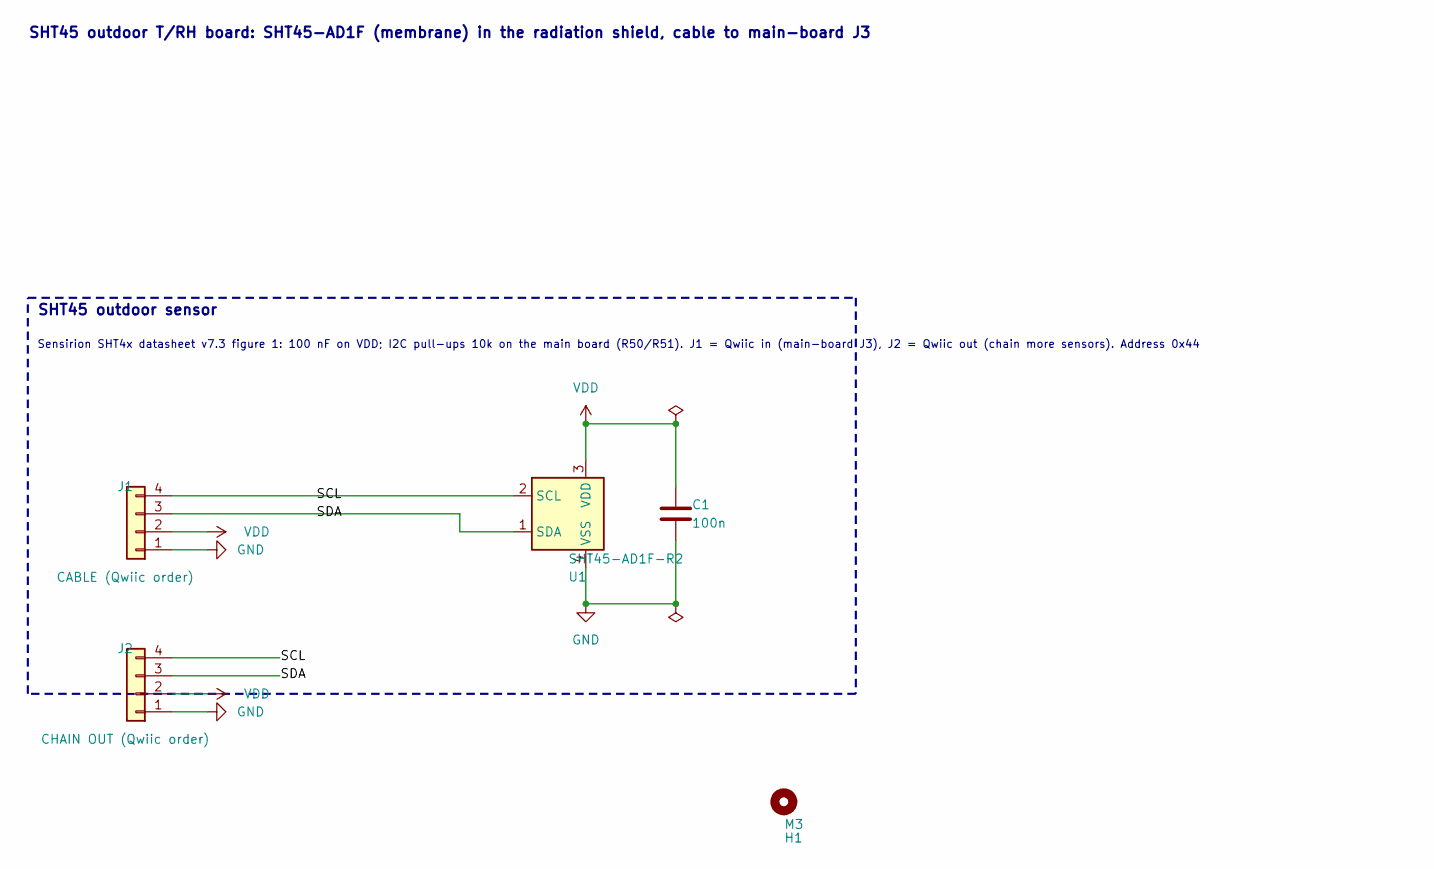
[picture p14: schematic sht45.kicad_sch, SHT45 outdoor T/RH board]

Parts:
C1: 100n; C_0603_1608Metric; LCSC C14663
H1: M3; MountingHole_3.2mm_M3
J1: CABLE (Qwiic order); JST_SH_SM04B-SRSS-TB_1x04-1MP_P1.00mm_Horizontal; LCSC C160404
J2: CHAIN OUT (Qwiic order); JST_SH_SM04B-SRSS-TB_1x04-1MP_P1.00mm_Horizontal; LCSC C160404
U1: SHT45-AD1F-R2; Sensirion_DFN-4_1.5x1.5mm_P0.8mm_SHT4x_NoCentralPad; LCSC C5360602

Connections:
/SHT45/SCL: J1.4, J2.4, U1.2 (SCL)
/SHT45/SDA: J1.3, J2.3, U1.1 (SDA)
GND: C1.2, J1.1, J2.1, U1.4 (VSS)
VDD: C1.1, J1.2, J2.2, U1.3 (VDD)

Notes on the sheet:
SHT45 outdoor sensor
Sensirion SHT4x datasheet v7.3 figure 1: 100 nF on VDD; I2C pull-ups 10k on the main board (R50/R51). J1 = Qwiic in (main-board J3), J2 = Qwiic out (chain more sensors). Address 0x44
SHT45 outdoor T/RH board: SHT45-AD1F (membrane) in the radiation shield, cable to main-board J3

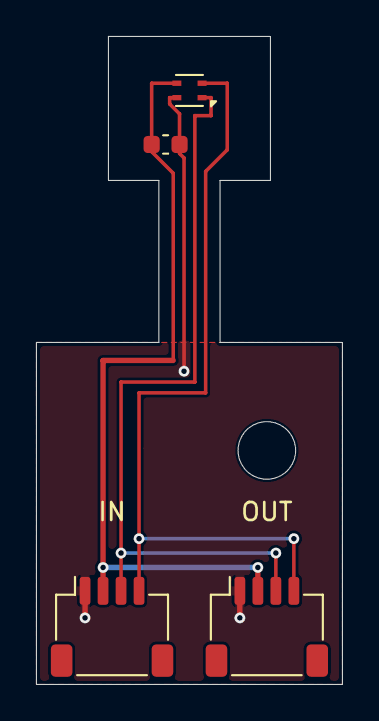
[picture p15: board sht45-board.kicad_pcb from above]

Board: 2 copper layers, 17.0 x 36.0 mm, 5 parts (0 on the bottom side), 4 nets.
