tobiwan88/esp32-weatherstation/hardware/veml6030-board/veml6030-board.kicad_pcb

## KiCad design hardware/veml6030-board/veml6030-board.kicad_pcb (2026-11-04)

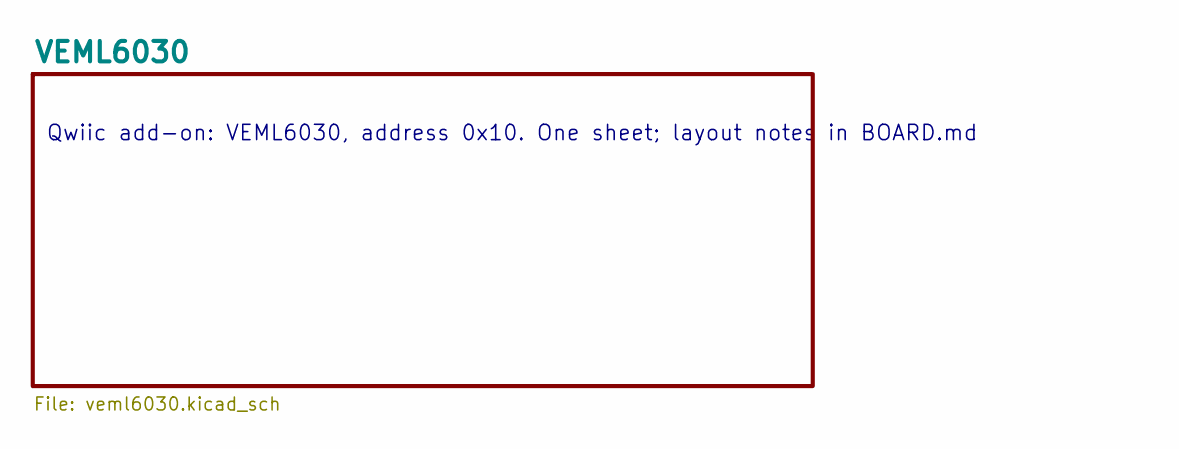
[picture p16: schematic veml6030-board.kicad_sch, VEML6030 light add-on (Qwiic)]

Notes on the sheet:
Qwiic add-on: VEML6030, address 0x10. One sheet; layout notes in BOARD.md

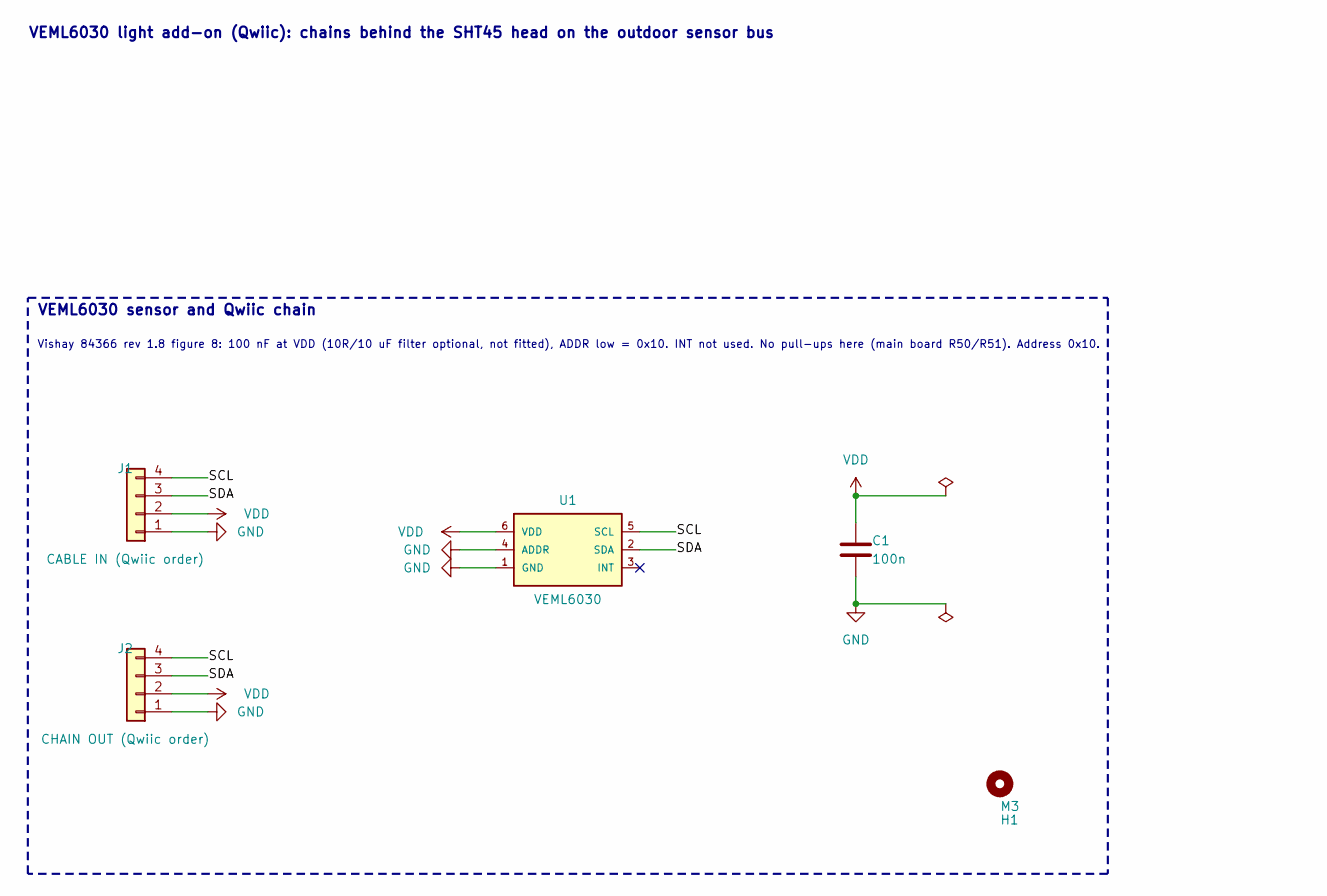
[picture p17: schematic veml6030.kicad_sch, VEML6030 light add-on (Qwiic)]

Parts:
C1: 100n; C_0603_1608Metric; LCSC C14663
H1: M3; MountingHole_3.2mm_M3
J1: CABLE IN (Qwiic order); JST_SH_SM04B-SRSS-TB_1x04-1MP_P1.00mm_Horizontal; LCSC C160404
J2: CHAIN OUT (Qwiic order); JST_SH_SM04B-SRSS-TB_1x04-1MP_P1.00mm_Horizontal; LCSC C160404
U1: VEML6030; Vishay_VEML6030_2x2mm; LCSC C132182

Connections:
/VEML6030/SCL: J1.4, J2.4, U1.5 (SCL)
/VEML6030/SDA: J1.3, J2.3, U1.2 (SDA)
GND: C1.2, J1.1, J2.1, U1.1 (GND), U1.4 (ADDR)
VDD: C1.1, J1.2, J2.2, U1.6 (VDD)

Notes on the sheet:
VEML6030 sensor and Qwiic chain
Vishay 84366 rev 1.8 figure 8: 100 nF at VDD (10R/10 uF filter optional, not fitted), ADDR low = 0x10. INT not used. No pull-ups here (main board R50/R51). Address 0x10.
VEML6030 light add-on (Qwiic): chains behind the SHT45 head on the outdoor sensor bus

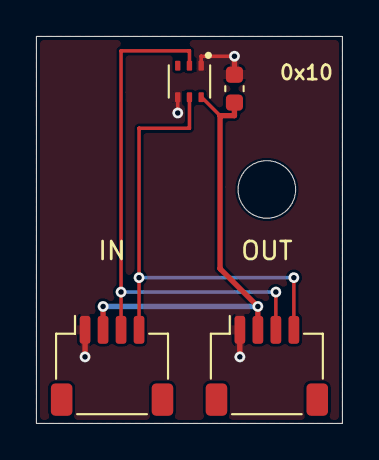
[picture p18: board veml6030-board.kicad_pcb from above]

Board: 2 copper layers, 17.0 x 21.5 mm, 5 parts (0 on the bottom side), 4 nets.
