tobiwan88/esp32-weatherstation/hardware/weatherstation-v1/board.yaml

# Board profile: the facts the board-neutral hardware skills and hardware/calc/ scripts read.
# Skills never hard-code a number; it lives here, in critical.yaml or in parts/<MPN>.yaml.
# Status: schematic generated; layout in progress (hardware/gen/pcb_v1.py).
name: weatherstation-v1
pcb: weatherstation-v1.kicad_pcb
sch: weatherstation-v1.kicad_sch
bom: bom.csv
generators: {schematic: ../gen/weatherstation_v1.py, layout: ../gen/pcb_v1.py}   # gen/layout_v1.py is the schematic block layout
notes: BOARD.md
requirements: REQUIREMENTS.md

fab:
  house: JLCPCB
  assembly: "JLCPCB PCBA, Economic (one side, SMT only); Standard if the quote forces it for the ESP32 module"
  rules: ../rules/jlc-4layer.json
  router_rules: ../rules/krt-fab.txt
  custom_drc: ../rules/weatherstation.kicad_dru
  extended_fee_usd: 3.07      # per unique non-preferred Extended part, Economic PCBA (jlcpcb.com/blog/reduce-pcb-assembly-cost-prototype, 2026-10)

# Requirement: 4 layers, two full ground planes (REQUIREMENTS.md 5). Dielectric/er numbers reused from the desk_notifier
# profile (jlcpcb.com/impedance, 2026-10); no impedance control ordered (no fast signals).
stackup:
  name: JLC04161H-7628
  copper_mm: 0.035
  soldermask: {thickness_mm: 0.015, er: 3.8}
  layers:
    - {name: F.Cu, role: signal, ref: In1.Cu, dielectric_mm: 0.2104, er: 4.4}
    - {name: In1.Cu, role: plane, net: GND}
    - {name: In2.Cu, role: plane, net: GND}
    - {name: B.Cu, role: signal, ref: In2.Cu, dielectric_mm: 0.2104, er: 4.4}

net_classes:   # nets use the full KiCad name (/Sheet/NET; global rails have no sheet). Widths checked by calc/track_width.py
  Default: {track_mm: 0.2, clearance_mm: 0.15, via_mm: 0.6, drill_mm: 0.3}
  # Charge path: 1.7 A (PV Imp 1.67 A, Voltaic P110; ILIM clamp 1.59 A; charge 1.5 A). Fine-pitch charger pins neck down.
  Charge: {track_mm: 0.65, clearance_mm: 0.15, via_mm: 0.6, drill_mm: 0.3, current_a: 1.7,
           nets: [USB_VBUS, VBUS, PMID, SYS, BAT_PACK, /Battery/BAT_CON, /Battery/BAT_N, /Battery/PB_MID, /Charger/SW1,
                  /Charger/SW2, /Charger/PV_IN, /Input/PV_RAW, /Input/PV_N_RAW, /Input/ACF1_MID, /Input/ACF2_MID]}
  # Rails: +3V3 0.5 A WiFi peak plus 3V3_SW; buck-boost inductor nodes about 1 A at low cell voltage; boost switch node.
  Power: {track_mm: 0.4, clearance_mm: 0.15, via_mm: 0.6, drill_mm: 0.3, current_a: 1.0,
          nets: [+3V3, 3V3_SW, 5V_SW, /Rails/BUCK_L1, /Rails/BUCK_L2, /Rails/GAS_SW]}
  USB: {track_mm: 0.27, gap_mm: 0.15, nets: [/USB_DP, /USB_DN]}

layout:
  stitch_pitch_mm: [2, 3]
  thermal_relief: {spoke_mm: 0.3, gap_mm: 0.25, spokes: 4}
  max_board_mm: [50, 50]      # 4-layer boards under 50 x 50 mm are in JLCPCB's cheapest tier (community cost guide)
  temp_rise_c: 10             # track temperature rise for calc/track_width.py (REQUIREMENTS T5: board rise < 25 C at 1.5 A)

alternates:
  C2913198:
    - {lcsc: C2913204, note: "ESP32-S3-WROOM-1-N8R2 (adds 2 MB PSRAM): check the module's reserved GPIOs before reusing the pin map"}
  C3001973:
    - {lcsc: C129529, note: "SMBJ12A TVS, MCC: same footprint (SMB)"}

power: []   # switching-regulator inputs for calc/buck.py: none (buck-boost and charger ICs are checked in design:)
# Inputs of calc/power_budget.py. value null = MISSING, no source = WARN (unsourced). `source: assumption` = still a guess.
design:
  charger:                 # BQ25798 (C2876593): register values written by firmware before CE is released
    vreg_v: {value: 3.65, source: "CBAK 26700LT spec A/03: standard end of charge 3.65 V (charge-policy.md)"}
    vreg_accuracy_mv: {value: 35, source: "BQ25798 datasheet SLUSDV2C section 6.5: VREG_ACC -0.45 % to +0.95 % (specified at VREG 4.2 V; worst high 0.95 % x 3.65 V = 35 mV, not specified at 3.65 V)"}
    ichg_a: {value: 1.5, source: "0.38C of 3.9 Ah; inside the HY2112 charge overcurrent (-170 mV minimum): 2 x 48 mOhm x 1.5 A = 144 mV; 1.9 A would trip it (power_budget check). Panel supplies about 1 A anyway"}
  hy2112:                  # HY2112-CB protection (U6) and its pack-negative FETs M60/M61
    fet_rds_ohm: {value: 0.048, source: "AO3400A (C20917) JLCPCB listing: 48 mOhm at 2.5 V gate; worst case used"}
    oc_charge_v: {value: 0.170, source: "HY2112-CB table 1 / section 9: charge overcurrent -200 mV +/- 30 mV, minimum magnitude 170 mV"}
    oc_discharge_v: {value: 0.185, source: "HY2112-CB section 9: discharge overcurrent 200 mV +/- 15 mV, minimum 185 mV"}
  cell:                    # CBAK 26700LT spec A/03 (LFP). Cold charging is firmware-managed (charge-policy.md).
    vmax_v: {value: 3.75, source: "CBAK 26700LT spec A/03: limited charge voltage 3.75 V (upper limit 3.8 V)"}
    cell_mah: {value: 3900, source: "CBAK 26700LT spec A/03: minimum capacity 3900 mAh (typical 4000)"}
    vcut_cell_v: {value: 2.0, source: "CBAK 26700LT spec A/03: standard discharge cut-off 2.0 V (must not exceed the HY2112 2.10 V detection)"}
    hy2112_overdischarge_v: {value: 2.10, source: "HY2112-CB datasheet DS-HY2112 V08 table 1: overdischarge detection 2.10 V"}
    vcutoff_firmware_v: {value: 2.4, source: "firmware policy: sensors off above the HY2112 detection (2.10 V) so the protection never acts on a normal load"}
  buckboost:               # TPS63802 (3.3 V), see cells.md and BOARD.md power review
    vin_min_v: {value: 1.3, source: "TPS63802 datasheet table 8.3: input voltage 1.3 V minimum (1.8 V to start)"}
    vout_v: 3.3
    path_r_ohm: {value: 0.15, source: "assumption: F1 PTC (about 40 mOhm) + M60/M61 AO3400A (about 35 mOhm each) + wiring"}
  panel:
    # Reference panel: Voltaic Systems P110 (10 W 6 V ETFE, 22.3 x 27.4 cm, 3.5 x 1.1 mm plug), voltaicsystems.com/p110,
    # also at DigiKey 12154976. Other 6 V 10 W listings: Lion Energy 6.16 V Vmp / 7.39 V Voc. Avoid "6 V" panels rated
    # Vmp 9 V / Voc 11 V (made for 6 V lead-acid): Voc above the SMBJ10A 10 V standoff.
    vmp_v: {value: 5.71, source: "Voltaic P110 product page: Vmp 5.71 V, Imp 1.67 A, 9.54 W, +/-10 %"}
    voc_v: {value: 6.94, source: "Voltaic P110 product page: Voc 6.94 V. Cold estimate (-0.3 %/K typical mono-Si, not on the page): about 7.9 V at -20 C, below the SMBJ10A 10 V standoff"}
  load:
    # cell-side peak: ESP32 WiFi TX (assumption about 0.35 A at 3.3 V -> about 0.4 A at the cell) + PMS7003 (0.1 A at 5 V ->
    # 0.19 A at 3.2 V with 85 % boost efficiency). The SCD41 (DNP) would add up to 0.205 A at 3.3 V when fitted.
    peak_a: {value: 0.6, source: "estimate: ESP32 TX about 0.4 A + PMS7003 0.19 A at the cell (PMS7003 manual V2.5: active <= 100 mA at 5 V)"}
    sensor_vmin_v: {value: 2.4, source: "SCD4x datasheet v1.7 table 4: VDD 2.4-5.5 V (SHT45 1.08-3.6 V); 3V3_SW is 3.32 V"}
  cycle:
    period_s: {value: 600, source: assumption}
    esp_active_s: {value: 15, source: assumption}
    esp_active_ma: {value: 100, source: assumption}
    sensor_on_s: {value: 45, source: "PMS7003 manual V2.5: stable data at least 30 s after wake-up; 45 s = 30 s + readings + margin"}
    sensor_ma: {value: 190, source: "PMS7003 manual V2.5: active <= 100 mA at 5 V; at the cell 5 V x 0.1 A / 0.85 (TPS61023, assumption) / 3.2 V = 184 mA, rounded up"}
    sleep_ua: {value: 100, source: assumption}
    # ZE25-O3 as a firmware option (user 2026-11-01): 5V_SW stays on longer for ozone, e.g. once per hour for 4 min
    # (warm-up <= 3 min + response <= 90 s, Winsen product page); PMS7003 in sleep (SET low) meanwhile.
    o3_on_s: {value: 240, source: "Winsen ZE25-O3 page: warm-up <= 3 min, response <= 90 s; 4 min window (firmware choice)"}
    o3_period_s: {value: 3600, source: "firmware choice: one O3 reading per hour"}
    o3_ma: {value: 20, source: "user 2026-11-04: ZE25-O3 10 mA at 5 V; at the cell 5 V x 10 mA / 0.85 (TPS61023) / 3.2 V = 18 mA, rounded up"}          # TPS63802 Iq 11 uA + HY2112 3 uA + module + dividers
  solar:
    panel_w: {value: 10, source: "decision 2026-11-01: 6 V class, about 10 W (e.g. Voltaic P110 9.5 W, or 2 x 6 V 5 W in parallel). Covers 0.96 Wh/day from 0.16 peak-sun hours, 1.5x margin from 0.24 h; replace with the bought panel's datasheet"}
    psh_worst_h: {value: 0.7, source: "design value for cloudy December, Germany. PVGIS-SARAH3 2005-2023, 45 deg: Dec mean 1.25 kWh/m2/d Frankfurt, 0.95 Hamburg; 27 % (Frankfurt) to 44 % (Hamburg) of Dec days below 0.5"}  # peak-sun hours per day
    system_eff: {value: 0.6, source: assumption}
