tobiwan88/esp32-weatherstation/(commit log)

2026-10-31 Base for esp32-weatherstation: hardware skills, tools, requirements, BOM
    - Copy board-neutral hardware skills (hw-base, hw-parts, kicad-schematic, kicad-layout),
    calc scripts, jlcparts lookup, fab rules and helper-agent prompts from desk_notifier (fedb410)
    - Keep desk_notifier generators, pipeline and profile under hardware/reference/ as a working example
    - Add weatherstation-v1 profile: REQUIREMENTS (4 layers, two GND planes, thermal, EMC, USB
    debug + charging, cost), bom.csv, board.yaml, critical.yaml, datasheet cards, BOARD.md, ORDER.md
    - Add gate scripts/hw-check.sh with new calc/bom_check.py and calc/power_budget.py (+ tests)
    - Add README, CLAUDE.md, privacy check, firmware placehol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
    [bom.csv]
2026-11-01 Schematic v1: BQ25798 charger, TPS63802 3.3 V, HY2112 LFP protection
    - Generated hierarchical KiCad schematic (input, charger, mcu, rails, sensors)
    from hardware/gen/weatherstation_v1.py; ERC clean (0 violations).
    - USB and PV inputs via BQ25798 back-to-back N-channel ACFET/RBFET pairs
    (AO3400A); PV protected by SMBJ24A, L3 common-mode choke (CMF4532F).
    - LFP 26700LT, firmware-managed cold charging (charge-policy.md).
    - HY2112-CB protection with pack-negative FETs M60/M61.
    - Power budget model rewritten for the BQ25798/HY2112/TPS63802 design.
    - Datasheet PDFs are not redistributed: ignored, sources listed in datasheets/SOURCES.md.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
    [bom.csv, charger.kicad_sch, input.kicad_sch, mcu.kicad_sch, rails.kicad_sch, sensors.kicad_sch, weatherstation-v1.kicad_sch]
2026-11-01 Schematic v1 review pass: parts review, I2C split, gas boost, readable drawing
    - PARTS-REVIEW.md: A1-A7 and B1-B7 decided and applied (common-drain HY2112 FETs, R23 removed,
    BAT caps on BAT, SMBJ10A + 3 A choke for a 6 V 10 W panel, CE pull-up to +3V3, two I2C buses,
    TPS61023 5 V boost for the ZE25-O3 with enable from IO12, TH1 to GND, R21 removed)
    - Project footprints from maker drawings: TPS63802 DLA, Sunlord WPN201610H, TDK VLS252010
    - Generator: rails as power symbols, block routing, hand routes for power stage / PV entry /
    HY2112 / sensor bus, root pins aligned, BOM one line per LCSC part
    - review_checks.py, schematic-review.sh, GATES.md; firmware rules in REQUIREMENTS section 6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
    [battery.kicad_sch, bom.csv, charger.kicad_sch, input.kicad_sch, mcu.kicad_sch, rails.kicad_sch, sensors.kicad_sch, weatherstation-v1.kicad_sch]
2026-11-01 Datasheets: CBAK 26700LT A03, Littelfuse SMBJ, ST USBLC6-2, HongyeX CMF4532F ratings
    Cell values in board.yaml match the CBAK spec. L3 land pattern still from the
    EMTEK drawing (open).
2026-11-01 Panel: Voltaic P110 as reference (Vmp 5.71 V, Voc 6.94 V)
    VOC_PCT 0.8125 matches its Vmp/Voc ratio; Voc stays below the SMBJ10A standoff
    when cold.
2026-11-01 BOM: move 8 passives to JLCPCB Basic (15 Extended, fee $46.05)
    BTST 47n and SDRV 1n X7R 50 V; ILIM 120k/100k (1.59 A clamp); TS 5.1k/30k
    (thresholds +0.9 C, cold on the safe side); HY2112 CS 2k; TPS63802 FB
    220k/39k = 3.32 V (R2 <= 100k); TPS61023 FB 510k/68k = 5.06 V.
    No Basic power inductor or NTC exists, so L1/L4/L5 and TH1 stay.
    [battery.kicad_sch, bom.csv, charger.kicad_sch, input.kicad_sch, mcu.kicad_sch, rails.kicad_sch, sensors.kicad_sch]
2026-11-01 REQUIREMENTS v0.4 for the BQ25798 / LFP 26700 / TPS63802 design
    Replaces the CN3791/TP4056/AP2112K/18650 text. Keeps the firmware rules and adds
    the MCU pin map, MPPT setting and open items. charge-policy.md: R20 goes to +3V3,
    and the CE-in-sleep rule is marked as an open decision (CE high in sleep would
    stop solar charging).
2026-11-01 Schematic: wire BAT_N, USB_VBUS and CC1/CC2 instead of labels
    Battery: cell minus drawn from J6 to the M60 drain and to HY2112 VSS/C60.
    Input: USB_VBUS one wire from J1 through U4 VBUS and C1 to ACFET1 with its
    flag; R9/R10 swapped so CC lines do not cross. Hand-drawn rails get one
    power symbol. ERC 0, nets OK, geometry 0.
    [battery.kicad_sch, charger.kicad_sch, input.kicad_sch, mcu.kicad_sch, rails.kicad_sch, sensors.kicad_sch, weatherstation-v1.kicad_sch]
2026-11-01 ZE25-O3 J8 7-pin, charger I2C to IO1/IO2 for the ULP, charging always on
    J8 numbered 1:1 to the Winsen pin table: DAC to IO7 (ADC1), RXD fed from IO17
    through 1k/10k (3.0 V max input), TXD to IO18, pins 1/7 reserved.
    Charger I2C moved to the RTC I2C pins (SDA IO1, SCL IO2) so the ULP RISC-V
    core can manage charging in deep sleep. charge-policy: CE held low in sleep
    (user decision), chip JEITA active.
    [battery.kicad_sch, bom.csv, charger.kicad_sch, input.kicad_sch, mcu.kicad_sch, rails.kicad_sch, sensors.kicad_sch, weatherstation-v1.kicad_sch]
2026-11-01 Sensor option A: PMS7003 + own SHT45 board + SCD41 footprint (DNP), SEN66 dropped
    J2 is now the PMS7003 (2x5 1.27 mm, manual V2.5) on the 5 V boost (rail renamed
    5V_SW, enable BOOST_EN), UART2 on IO4/IO5 with SET on IO6 (1k series on the
    outputs). U8 SCD41 footprint on 3V3_SW and the sensor bus, not fitted. No
    VOC/NOx index (needs 1 Hz sampling, not deep-sleep friendly).
    power_budget: generic sensor_on_s/sensor_ma (PMS7003 190 mA at the cell for
    45 s), energy at the LFP 3.2 V nominal (was 3.7 V). 16.9 mA avg, 1.29 Wh/day,
    7.7 days autonomy. Extended parts 14, fee $42.98.
    [battery.kicad_sch, bom.csv, charger.kicad_sch, input.kicad_sch, mcu.kicad_sch, rails.kicad_sch, sensors.kicad_sch, weatherstation-v1.kicad_sch]
2026-11-01 SHT45 outdoor board (schematic), O3 long-on firmware option in the budget
    hardware/sht45-board: SHT45-AD1F (membrane, C5360602), 100 nF, JST SH in Qwiic
    order like main-board J3; pull-ups and ESD stay on the main board. Generator
    hardware/gen/sht45_board.py (ERC 0, nets OK); layout rules from the Sensirion
    design guide in its BOARD.md. schkit: project/title parameters.
    ZE25-O3: firmware keeps 5V_SW on 4 min per hour; power_budget counts it with an
    assumed 80 mA (22.2 mA avg, 1.70 Wh/day, 5.9 days, solar 2.5x).
    [bom.csv, sht45-board.kicad_sch, sht45.kicad_sch]
2026-11-01 Skills: requirements-first cost and duty cycle, change propagation, parts checklist; simplify kicad-schematic
    hw-base: cost target and power-cycle fit before the schematic, deep-sleep pins
    reserved, every copy of a changed decision updated (docs follow the netlist),
    rules for research agents.
    hw-parts: basic values chosen with the math, maker match, datasheet download
    recipe, value swaps recompute every formula; new pitfalls.
    kicad-schematic: board-specific names removed, lessons folded into the rules,
    pass-through nets, hand-drawn rails, DNP parts, .net ignore; 115 -> 95 lines.
    hardware/gen/pins.py: pin positions in cells for hand routes.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
    [pins.py]
2026-11-01 BOARD.md: schematic generator, review loop and pins.py commands
2026-11-01 Layout: skill and rules review, PCB generator with first placement
    - kicad-layout skill: requirements first (docs vs netlist, area budget, floorplan, widths
    from current), rule-based passive placement, review loop, new pitfalls
    - critical.yaml rewritten for BQ25798/TPS63802/TPS61023 (was CN3791/TP4056)
    - board.yaml: Charge/Power net classes with current, calc/track_width.py (IPC-2221) in the gate
    - hardware/gen/pcb_v1.py: 50x50 4-layer outline, floorplan, greedy placer for passives,
    two GND planes, keepouts (antenna strip, J1 shell, B.Cu under inductors, M3 holes)
    - tools: build_pcb.sh, route_krt.sh, board_geom/render_review, merged .kicad_pro writer
    - rules/weatherstation.kicad_dru; BOA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
    [weatherstation-v1.kicad_pcb]
2026-11-01 BOARD.md: first routing trial result (18 of 71 nets open, density decision open)
2026-11-01 Layout: J4 dropped, THT connector bodies on the back (engineer decision)
    - schematic: J4 spare Qwiic port removed (ERC 0, nets OK), BOM and docs updated
    - pcb_v1.py: J2/J5/J6/J7/J8 on B.Cu, front blocked only by their pads; no back bodies at the
    hole standoffs; EN cap placed before the module bulk caps
    - front courtyards 76 % -> 67 %; routing trial 2: 60/71 nets, open nets in the charger corner
    and the USB pair (BOARD.md)
    [battery.kicad_sch, bom.csv, charger.kicad_sch, input.kicad_sch, mcu.kicad_sch, rails.kicad_sch, sensors.kicad_sch, weatherstation-v1.kicad_pcb]
2026-11-02 Layout: BQ25798 power stage drawn by hand (TI layout), staged routing, pour renders
    The autorouter could not lay out the charger: every order (power first, signals first,
    QFN fanout first, narrower charge tracks) walled in the other half of U3's 0.4 mm pin
    row, at 50x50 and 55x55, and its switch-node copper wandered.
    - gen/pcb_v1.py: CHARGER block placed relative to U3 per SLUSDV2C 8.4.1/Figure 8-21:
    C9/C13 on the PMID-SW1-GND-SW2-SYS pin row sharing GND, SW1/SW2 through 2 vias
    under the IC to 0.6 mm B.Cu and back up at L1 above the caps, PMID/SYS bulk caps in
    columns joined by F.Cu pours, GND via per cap; all locked. Placer keeps parts off
    the drawn copper and keeps escape bands be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
    [battery.kicad_sch, bom.csv, charger.kicad_sch, input.kicad_sch, mcu.kicad_sch, rails.kicad_sch, sensors.kicad_sch, weatherstation-v1.kicad_pcb]
2026-11-02 Layout: 0402 Basic passives, charger small parts placed by hand
    - 34 passives to 0402 Basic parts (engineer: 0402 wherever Basic, reuse part numbers);
    values without a Basic 0402 and DC-bias-limited caps stay 0603. Extended count
    unchanged (14). ERC 0, nets OK, bom_check OK.
    - CHARGER ring around U3 in pin order (BAT cap, PROG, BTST2, ILIM, TS, BATP, SDRV on
    the right; VBUS, BTST1, REGN caps on the left), courtyards from the real footprints.
    Charger pull-ups moved to the MCU end of their nets.
    - Routing trial 4: 5 of 71 nets open (was 10).
    [battery.kicad_sch, bom.csv, charger.kicad_sch, input.kicad_sch, mcu.kicad_sch, rails.kicad_sch, sensors.kicad_sch, weatherstation-v1.kicad_pcb]
2026-11-02 Layout: TPS63802 block placed by hand (TI 12.1), FB divider at the pin
    [weatherstation-v1.kicad_pcb]
2026-11-02 Layout: USB pair and TPS61023 block drawn by hand, USB closes
    USB_COPPER: flow-through U4, DP crossing on B.Cu, CC1 on B.Cu, BC1.2 stubs under U3.
    BOOST block per SLVSF14B Figure 10-1. route_krt.sh gains a usb (route_diff) stage.
    [weatherstation-v1.kicad_pcb]
2026-11-03 Tweezer pads for RESET/BOOT, two status LEDs on IO41/IO42, SYS caps joined
    Engineer 2026-11-03: 5.1 mm buttons replaced by solder-jumper pads JP1/JP2 (not
    assembled); D10/D11 red 0603 (C2286, same as D2) with 1k (C11702). C17/C18 fixed
    above C16 with a hand SYS track. U3 bottom-row fanout kept behind PCB_FAN=1.
    [battery.kicad_sch, bom.csv, charger.kicad_sch, input.kicad_sch, mcu.kicad_sch, rails.kicad_sch, sensors.kicad_sch, weatherstation-v1.kicad_pcb]
2026-11-03 Layout: weatherstation-v1 fully routed, DRC clean
    route_v1.sh routes the placed board end to end: KRT planes, power, rest,
    rip-up finishing pass, Charge tracks widened where they fit, via nudge and
    dangling cleanup. Result: 0 DRC errors, 0 unconnected pads, schematic parity
    clean, In1/In2 solid GND, critical.py OK; 5 of 6 router settings agree.
    Hand copper that closed it: U3 right-column fan, U3 bottom row as one nested
    B.Cu bundle (ACDRV1/2, CE, SDA, SCL), REGN lane, BAT_PACK and USB_VBUS
    trunks, boost/buck-boost local nodes, USBLC6 flow-through links, escape vias
    for R48/R49. J1 shell keepout is a real F.Cu keepout (B.Cu is a lane), KRT
    fab floors pinned to the project DRC, USB_VBUS taps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
    [weatherstation-v1.kicad_pcb]
2026-11-04 VBUS via at U3 0.6/0.3, USB impedance check recorded, ZE25-O3 10 mA
    - C6-side VBUS layer change 0.6/0.3 with a 0.65 mm link; STAT lifted beside it, west diagonal unchanged
    (the router's USB_VBUS path to U4/J1 A9 passes there). Re-routed: 0 DRC errors.
    - USB pair: net class 0.27/0.15 = 90.6 ohm; routed pair 115-135 ohm, 30 mm, full speed only: accepted.
    - ZE25-O3 10 mA at 5 V (user): o3_ma 20 mA at the cell, power budget OK.
    [weatherstation-v1.kicad_pcb]
2026-11-04 SHT45 sensor head laid out (Qwiic chain out), J1 A9/B4 VBUS link by hand
    - sht45-board: J2 Qwiic out wired 1:1 (chain more I2C sensors), H1 M3; gen/sht45_pcb.py draws the whole
    2-layer board: 17 x 36 mm, sensor island on a 3.4 mm neck with four 0.2 mm traces, GND pours on the base
    only; build_sht45.sh runs schematic -> board -> DRC. 0 errors, 0 unconnected, parity clean.
    - weatherstation-v1: J1 A9/B4 hand link under R10 (0.4/0.25 mm, was 0.127 mm), R9 GND via; U4 pin 5 router
    link now 0.2 mm. Re-routed: 0 DRC errors.
    [bom.csv, sht45-board.kicad_pcb, sht45-board.kicad_sch, sht45.kicad_sch, weatherstation-v1.kicad_pcb]
2026-11-04 Qwiic add-on boards: BMP585 pressure and VEML6030 light (same base as the SHT45 head)
    - Project symbols and footprints for BMP585 (Bosch DS003-02 rev 1.2) and VEML6030 (Vishay 84366 rev 1.8)
    - gen/addon_boards.py + gen/addon_pcb.py, tools/build_addons.sh: ERC 0, nets OK, 0 DRC violations, parity clean
    - Netlist fields (LCSC numbers) no longer printed on silk: SHT45 head now 0 DRC warnings too
    [bmp585-board.kicad_pcb, bmp585-board.kicad_sch, bmp585.kicad_sch, bom.csv, sht45-board.kicad_pcb, sht45.kicad_sch, veml6030-board.kicad_pcb, veml6030-board.kicad_sch]
2026-11-05 JLCPCB production files: fab package with CPL fitted to JLC footprints; L3 land pattern fixed
    - tools/fab_package.py: DRC gate (waivers per part, warnings only), gerbers + drill zip, BOM, CPL.
    CPL angle and centre come from fitting each part's EasyEDA footprint (what JLC's preview uses)
    onto the placed pads; catches U1 origin (3.65 mm), J1 (1.5 mm), SOT-23 (180), USBLC6 (270), L3 (90).
    - L3 CMF4532F footprint: EMTEK 7-1 re-read (0.7 mm is the row gap); pads 1.15 x 1.55 at +/-1.825, +/-1.125,
    swapped on the routed board, one router GND track under the choke removed (GND via planes, DRC clean).
    - tools/silk_fix.py: silk clipped at the edge, pin-1 marks moved off pads; edited footprints i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
    [drc-waivers.csv, weatherstation-v1.kicad_pcb]
2026-11-05 Skills: fab-footprint fit instead of rotation tables, land overlap check, DRC at all severities, waiver file
    - hw-parts: hand-drawn footprints checked against terminal overlap and the fab's own footprint; CPL from the fit;
    polite fab API use; pitfalls (gap read as pad size, other pin numbering).
    - kicad-layout: silk cleanup step, gate at all severities, drc-waivers.csv, footprint swap on a routed board,
    pcbnew SWIG pitfalls.
    - hw-base: ORDER.md among the copies to update, waiver file, GUI-saved .kicad_pro rule, timebox tooling detours.
    - hw-check.sh runs fab_package.py --fit-only --offline on all boards (MISSING without cache, FAIL on a bad fit).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
